kicksat/avionics/README.md

avionics
========

# This repo is no longer being updated. Please see the individual repos for the mainboard, solar panels, and antenna.

# License

[Creative Commons Attribution-ShareAlike 4.0 International](https://creativecommons.org/licenses/by-sa/4.0/)
