kicksat/avionics/kicksat1/Mainboard BOM.xlsx

Qty | Value | Device | Package | Parts | Description
3 | 4.7k | Resistor | 0805 | R1, R2, R3 | Resistor
1 | 120k | Resistor | 0805 | R4 | Resistor
1 | 68k | Resistor | 0805 | R5 | Resistor
5 | 3K3 | Resistor | 0805 | R6, R12, R17, R19, R23 | Resistor
2 | .1R prec | Resistor | 0805 | R7, R16 | Resistor
5 | 10K | Resistor | 0805 | R8, R13, R18, R21, R24 | Resistor
5 | 4.7K | Resistor | 0805 | R9, R14, R20, R22, R25 | Resistor
2 | 4.7R | Resistor | 2512 | R10, R11 | Resistor
1 | 1.33K | Resistor | 0805 | R15 | Resistor
3 | 0.1uF | Capacitor | 0805 | C1, C4, C6 | Capacitor
1 | 4.7uF | Capacitor | 0805 | C2 | Capacitor
1 | .22uF | Capacitor | 0805 | C3 | Capacitor
1 | 10nF | Capacitor | 0805 | C5 | Capacitor
1 | 2.2nF | Capacitor | 0805 | C7 | Capacitor
8 | .1uF | Capacitor | 0805 | C8, C9, C11, C13, C14, C15, C16, C17 | Capacitor
2 | 22uF | Capacitor | 1206 | C10, C12 | Capacitor
5 | MOSFET_PCHAN_20A | MOSFET_PCHAN_20A | SO8 | T1, T3, T5, T7, T9 | Power MOSFET for Burn Wires
5 | SINGLE_NCHAN_FET | SINGLE_NCHAN_FET | SOT23-3 | T2, T4, T6, T8, T10 | MOSFET for burn wire circuit
1 | RFM23BP | RFM23BP | RFM23BP | U1 | HopeRF RFM23BP Radio
1 | ARDUINO_PRO_MINI | ARDUINO_PRO_MINI | ARDUINO_PRO_MINI | U2 | Watchdog MCU
1 | HMC5883LSMD | HMC5883LSMD | 16LPCC | U3 | 3 Axis Digital Compass IC
1 | TEENSY_3.0+4 | TEENSY_3.0+4 | TEENSY_3.0+4 | U4 | Flight computer MCU
1 | ITG-3200 | ITG-3200 | QFN-24 | U5 | ITG-3200 3-axis gyro, digital output, qfn24 package
2 | CURRENT_MAX4372 | CURRENT_MAX4372 | SOT23-5 | U6, U8 | Current Sense Amplifier
1 | MURATA_REG_OKL-T3-W12 | MURATA_REG_OKL-T6-W12 | MURATA_REG_OKL-T6-W12 | U7 | Switching Regulator
5 | M023.5MM_LOCK | M023.5MM_LOCK | SCREWTERMINAL-3.5MM-2_LOCK | ST1, ST2, ST3, ST4, ST5 | Screw terminals for battery + foot switch connections
1 | BU-SMA-V | BU-SMA-V | BU-SMA-V | SMA1 | Antenna connector (MCX)
1 | CONN_5-1-53261 | CONN_5-1-53261 | PB-53261-05 | JP8 | Piksi GPS connector
7 | M03POLAR_LOCK | M03POLAR_LOCK | MOLEX-1X3_LOCK | JP1, JP2, JP3, JP4, JP5, JP6, JP7 | Solar Panel Connectors
1 | POWER_JACKPTH_LOCK | POWER_JACKPTH_LOCK | POWER_JACK_PTH_LOCK | J1 | Charging Jack
1 | DPDT | SWITCH-DPDTAYZ0202 | AYZ0202 | S1 | Switch for MCU programming mode
