kicksat/avionics/kicksat1/Mainboard.brd

## EAGLE design kicksat1/Mainboard.brd (2017-02-05)

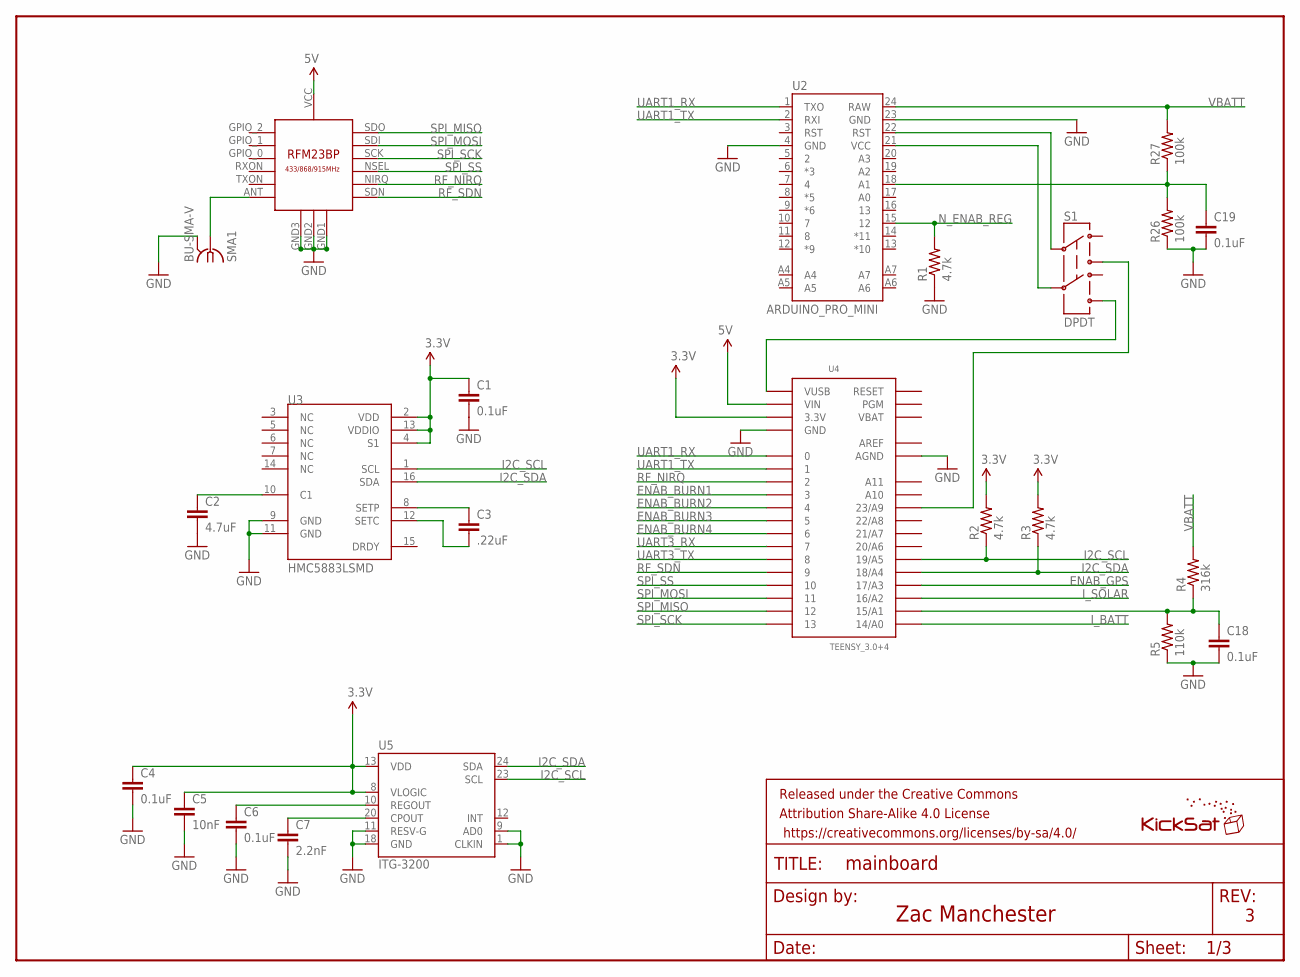
[picture p1: schematic Mainboard.sch, sheet 1, Avionics]

Parts:
C1, C4, C6, C18, C19: 0.1uF; 0805
C2: 4.7uF; 0805
C3: .22uF; 0805
C5: 10nF; 0805
C7: 2.2nF; 0805
FRAME1: FRAME-LETTER; CREATIVE_COMMONS
R1, R2, R3: 4.7k; 0805
R4: 316k; 0805
R5: 110k; 0805
R26, R27: 100k; 0805
S1: DPDT; AYZ0202
SMA1: BU-SMA-V
U1: RFM23BP
U2: ARDUINO_PRO_MINI
U3: HMC5883LSMD; 16LPCC
U4: TEENSY_3.0+4
U5: ITG-3200; QFN-24
U$3: KICKSAT_LOGO

Connections:
3.3V: C1.1, C4.1, C5.1, R2.2, R3.2, U3.2 (VDD), U3.4 (S1), U3.13 (VDDIO), U4.3.3V, U4.3.3V1 (3.3V), U5.8 (VLOGIC), U5.13 (VDD); also elsewhere on the board
5V: U1.VCC, U4.VIN; also elsewhere on the board
AREF: U4.AREF
ENAB_BURN1: U4.3; also elsewhere on the board
ENAB_BURN2: U4.4; also elsewhere on the board
ENAB_BURN3: U4.5; also elsewhere on the board
ENAB_BURN4: U4.6; also elsewhere on the board
ENAB_GPS: U4.17/A3; also elsewhere on the board
GND: C1.2, C2.2, C4.2, C5.2, C6.2, C7.2, C18.2, C19.2, R1.1, R5.1, R26.1, SMA1.2, SMA1.3 (2), SMA1.4 (2), SMA1.5 (2), U1.GND1, U1.GND2, U1.GND3, U2.4 (GND), U2.23 (GND), U3.9 (GND), U3.11 (GND), U4.AGND, U4.GND, U4.GND1 (GND), U5.1 (CLKIN), U5.9 (AD0), U5.11 (RESV-G), U5.18 (GND); also elsewhere on the board
I2C_SCL: R2.1, U3.1 (SCL), U4.19/A5, U5.23 (SCL)
I2C_SDA: R3.1, U3.16 (SDA), U4.18/A4, U5.24 (SDA)
I_BATT: U4.14/A0; also elsewhere on the board
I_SOLAR: U4.16/A2; also elsewhere on the board
unnamed: S1.3, U4.23/A9
unnamed: S1.6, U4.VUSB
unnamed: C19.1, R26.2, R27.1, U2.18 (A1)
unnamed: SMA1.1, U1.ANT
unnamed: C18.1, R4.1, R5.2, U4.15/A1
unnamed: C7.1, U5.20 (CPOUT)
unnamed: C6.1, U5.10 (REGOUT)
unnamed: C2.1, U3.10 (C1)
unnamed: C3.1, U3.8 (SETP)
unnamed: C3.2, U3.12 (SETC)
N_ENAB_REG: R1.2, U2.15 (12); also elsewhere on the board
PGM_RST: S1.2, U2.22 (RST)
PGM_VCC: S1.5, U2.21 (VCC)
RF_NIRQ: U1.NIRQ, U4.2
RF_SDN: U1.SDN, U4.9
SPI_MISO: U1.SDO, U4.12
SPI_MOSI: U1.SDI, U4.11
SPI_SCK: U1.SCK, U4.13
SPI_SS: U1.NSEL, U4.10
UART1_RX: U2.1 (TXO), U4.0
UART1_TX: U2.2 (RXI), U4.1
UART3_RX: U4.7; also elsewhere on the board
UART3_TX: U4.8; also elsewhere on the board
VBAT: U4.VBAT
VBATT: R4.2, R27.2, U2.24 (RAW); also elsewhere on the board

Notes on the sheet:
Zac Manchester

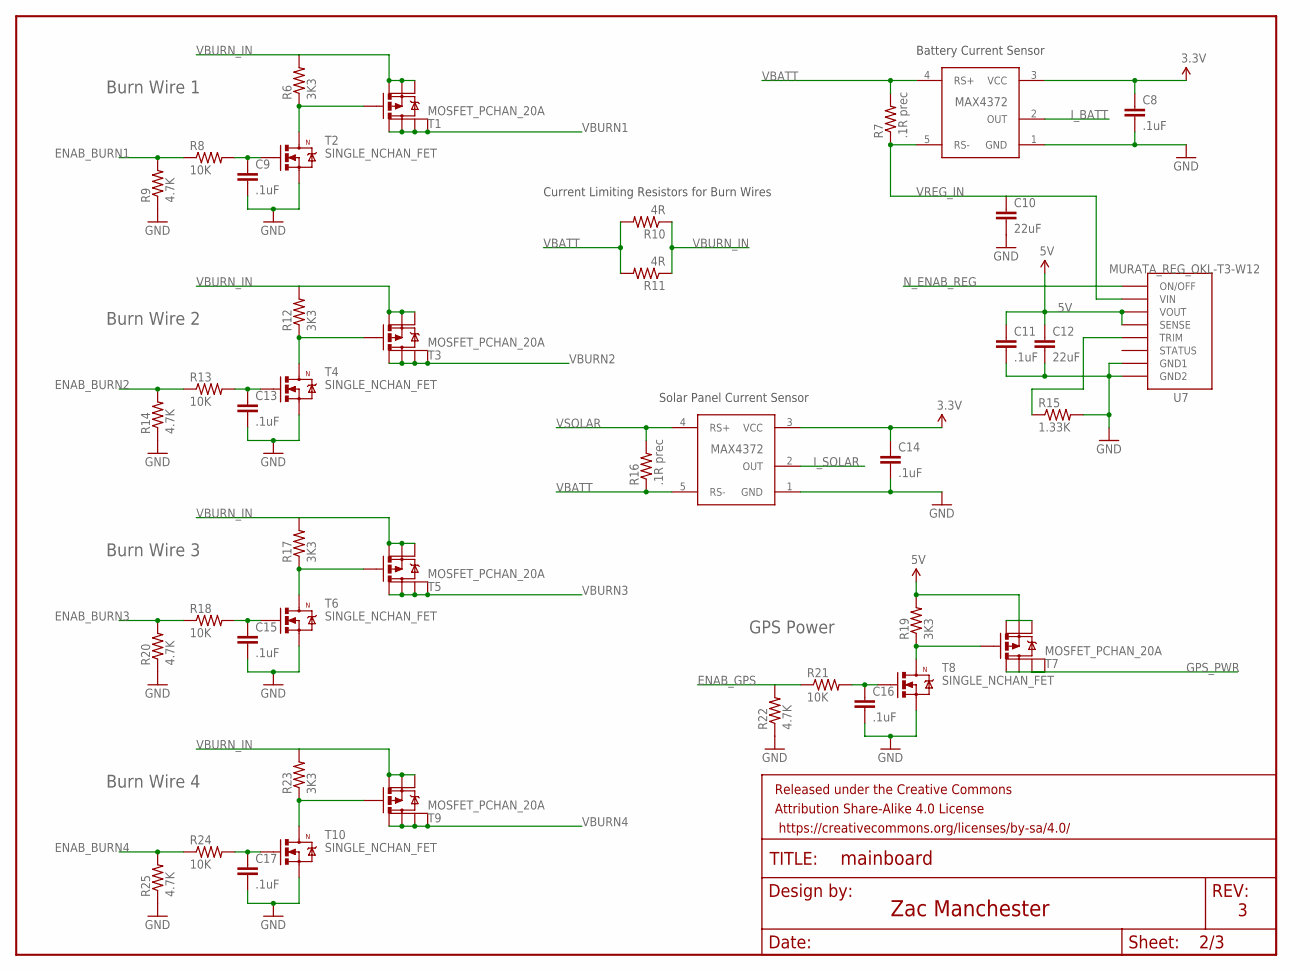
[picture p2: schematic Mainboard.sch, sheet 2, Power]

Parts:
C8, C9, C11, C13, C14, C15, C16, C17: .1uF; 0805
C10, C12: 22uF; 1206
FRAME2: FRAME-LETTER; CREATIVE_COMMONS
R6, R12, R17, R19, R23: 3K3; 0805
R7, R16: .1R prec; 0805
R8, R13, R18, R21, R24: 10K; 0805
R9, R14, R20, R22, R25: 4.7K; 0805
R10, R11: 4R; R2512
R15: 1.33K; 0805
T1, T3, T5, T7, T9: MOSFET_PCHAN_20A; SO8
T2, T4, T6, T8, T10: SINGLE_NCHAN_FET; SOT23-3
U6, U8: CURRENT_MAX4372; SOT23-5
U7: MURATA_REG_OKL-T3-W12; MURATA_REG_OKL-T6-W12

Connections:
3.3V: C8.1, C14.1, U6.3 (VCC), U8.3 (VCC); also elsewhere on the board
5V: C11.1, C12.1, R19.2, T7.1 (S), T7.2 (S), T7.3 (S), U7.4 (VOUT), U7.5 (SENSE); also elsewhere on the board
ENAB_BURN1: R8.1, R9.2; also elsewhere on the board
ENAB_BURN2: R13.1, R14.2; also elsewhere on the board
ENAB_BURN3: R18.1, R20.2; also elsewhere on the board
ENAB_BURN4: R24.1, R25.2; also elsewhere on the board
ENAB_GPS: R21.1, R22.2; also elsewhere on the board
GND: C8.2, C9.2, C10.2, C11.2, C12.2, C13.2, C14.2, C15.2, C16.2, C17.2, R9.1, R14.1, R15.2, R20.1, R22.1, R25.1, T2.2 (S), T4.2 (S), T6.2 (S), T8.2 (S), T10.2 (S), U6.1 (GND), U7.3 (GND1), U7.7 (GND2), U8.1 (GND); also elsewhere on the board
GPS_PWR: T7.5 (D), T7.6 (D), T7.7 (D), T7.8 (D); also elsewhere on the board
I_BATT: U6.2 (OUT); also elsewhere on the board
I_SOLAR: U8.2 (OUT); also elsewhere on the board
unnamed: C13.1, R13.2, T4.1 (G)
unnamed: R12.1, T3.4 (G), T4.3 (D)
unnamed: C15.1, R18.2, T6.1 (G)
unnamed: R17.1, T5.4 (G), T6.3 (D)
unnamed: R15.1, U7.6 (TRIM)
unnamed: C17.1, R24.2, T10.1 (G)
unnamed: R23.1, T9.4 (G), T10.3 (D)
unnamed: C16.1, R21.2, T8.1 (G)
unnamed: R19.1, T7.4 (G), T8.3 (D)
unnamed: C9.1, R8.2, T2.1 (G)
unnamed: R6.1, T1.4 (G), T2.3 (D)
N_ENAB_REG: U7.1 (ON/OFF); also elsewhere on the board
VBATT: R7.2, R10.2, R11.2, R16.1, U6.4 (RS+), U8.5 (RS-); also elsewhere on the board
VBURN1: T1.5 (D), T1.6 (D), T1.7 (D), T1.8 (D); also elsewhere on the board
VBURN2: T3.5 (D), T3.6 (D), T3.7 (D), T3.8 (D); also elsewhere on the board
VBURN3: T5.5 (D), T5.6 (D), T5.7 (D), T5.8 (D); also elsewhere on the board
VBURN4: T9.5 (D), T9.6 (D), T9.7 (D), T9.8 (D); also elsewhere on the board
VBURN_IN: R6.2, R10.1, R11.1, R12.2, R17.2, R23.2, T1.1 (S), T1.2 (S), T1.3 (S), T3.1 (S), T3.2 (S), T3.3 (S), T5.1 (S), T5.2 (S), T5.3 (S), T9.1 (S), T9.2 (S), T9.3 (S)
VREG_IN: C10.1, R7.1, U6.5 (RS-), U7.2 (VIN)
VSOLAR: R16.2, U8.4 (RS+); also elsewhere on the board

Notes on the sheet:
Burn Wire 1
Burn Wire 2
Burn Wire 3
Solar Panel Current Sensor
Battery Current Sensor
Burn Wire 4
Current Limiting Resistors for Burn Wires
Zac Manchester
GPS Power

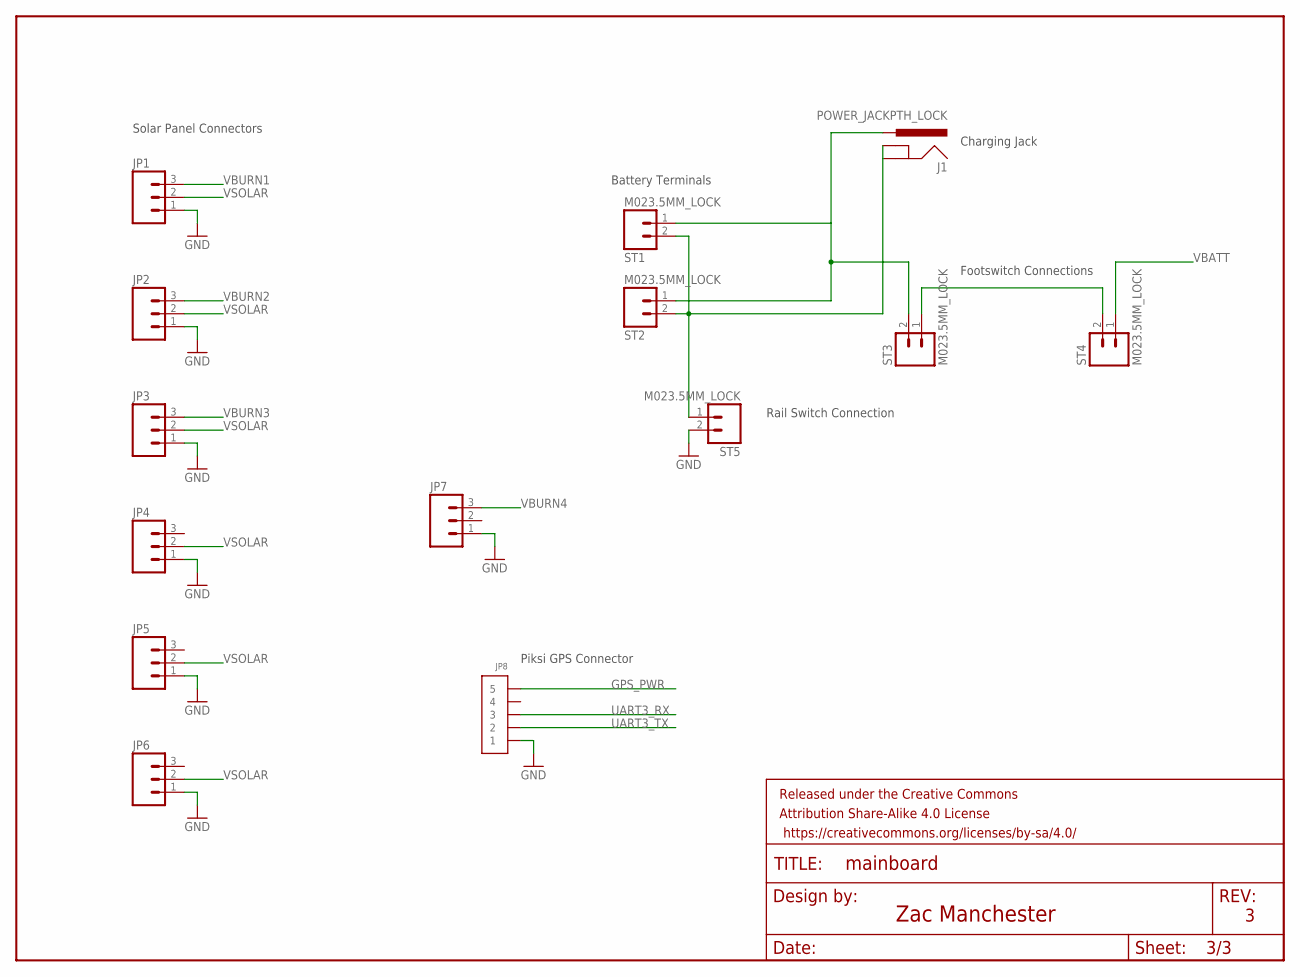
[picture p3: schematic Mainboard.sch, sheet 3, Connectors]

Parts:
FRAME3: FRAME-LETTER; CREATIVE_COMMONS
J1: POWER_JACKPTH_LOCK; POWER_JACK_PTH_LOCK
JP1, JP2, JP3, JP4, JP5, JP6, JP7: M03POLAR_LOCK; MOLEX-1X3_LOCK
JP8: CONN_5-1-53261; PB-53261-05
ST1, ST2, ST3, ST4, ST5: M023.5MM_LOCK; SCREWTERMINAL-3.5MM-2_LOCK

Connections:
BATT_INPUT: J1.PWR, ST1.1, ST2.1, ST3.2
GND: JP1.1, JP2.1, JP3.1, JP4.1, JP5.1, JP6.1, JP7.1, JP8.1, ST5.2; also elsewhere on the board
GPS_PWR: JP8.5; also elsewhere on the board
unnamed: J1.GND, J1.GNDBREAK, ST1.2, ST2.2, ST5.1
unnamed: ST3.1, ST4.2
UART3_RX: JP8.3; also elsewhere on the board
UART3_TX: JP8.2; also elsewhere on the board
VBATT: ST4.1; also elsewhere on the board
VBURN1: JP1.3; also elsewhere on the board
VBURN2: JP2.3; also elsewhere on the board
VBURN3: JP3.3; also elsewhere on the board
VBURN4: JP7.3; also elsewhere on the board
VSOLAR: JP1.2, JP2.2, JP3.2, JP4.2, JP5.2, JP6.2; also elsewhere on the board

Notes on the sheet:
Footswitch Connections
Solar Panel Connectors
Battery Terminals
Rail Switch Connection
Charging Jack
Piksi GPS Connector
Zac Manchester

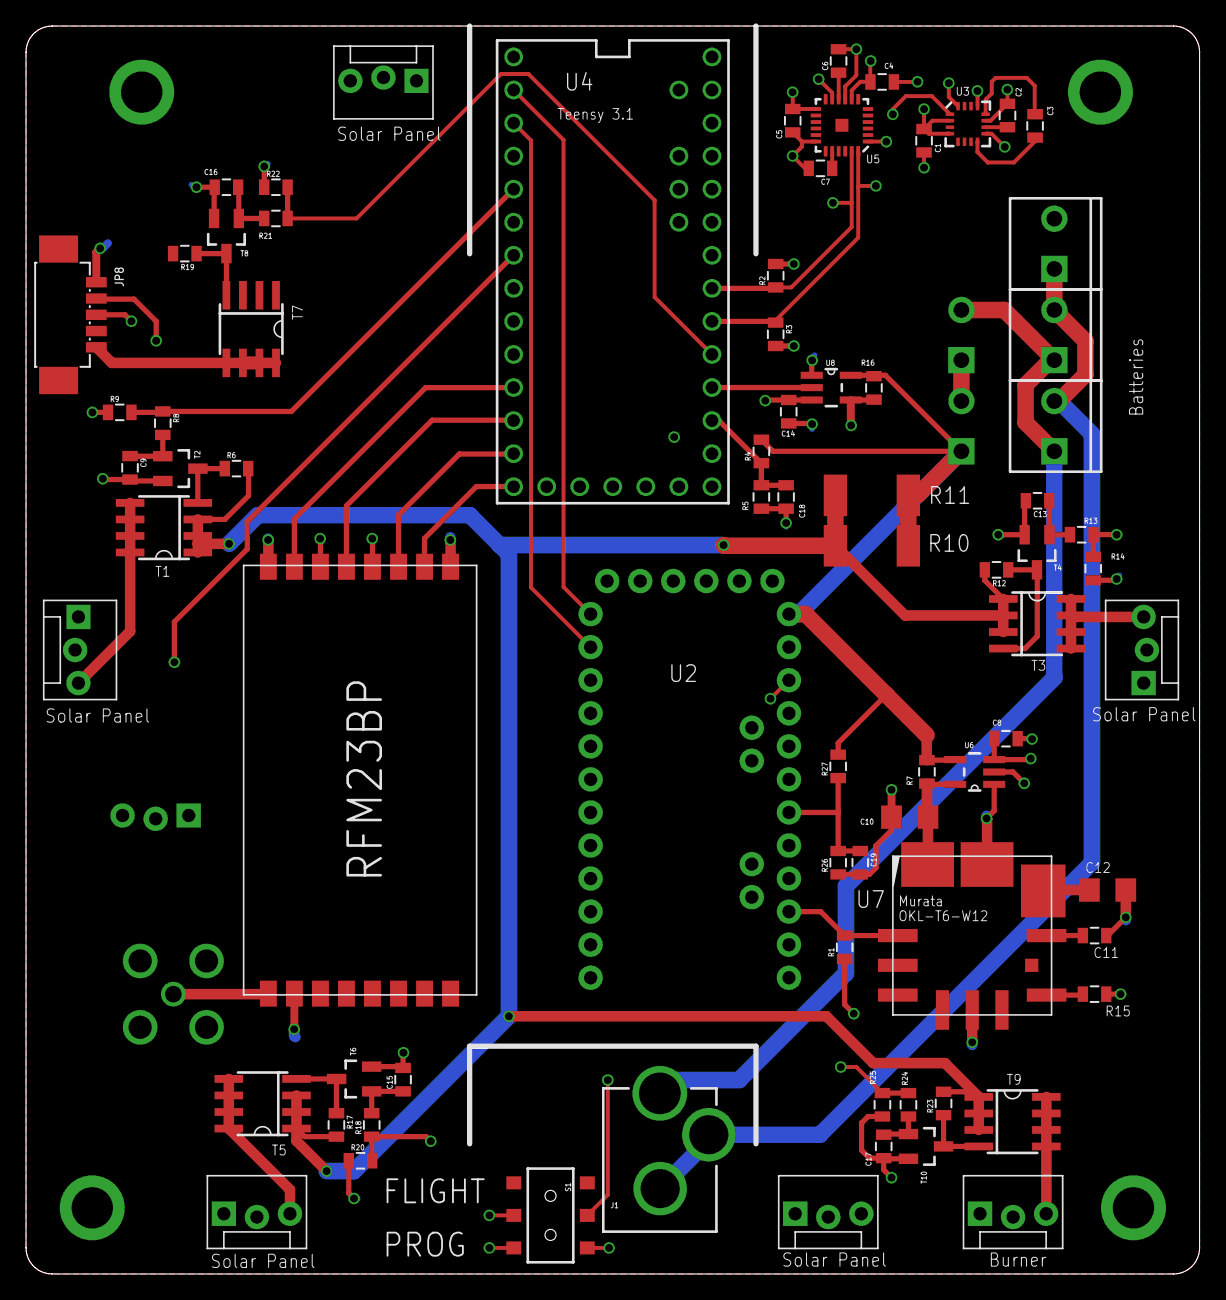
[picture p4: board Mainboard.brd from above]

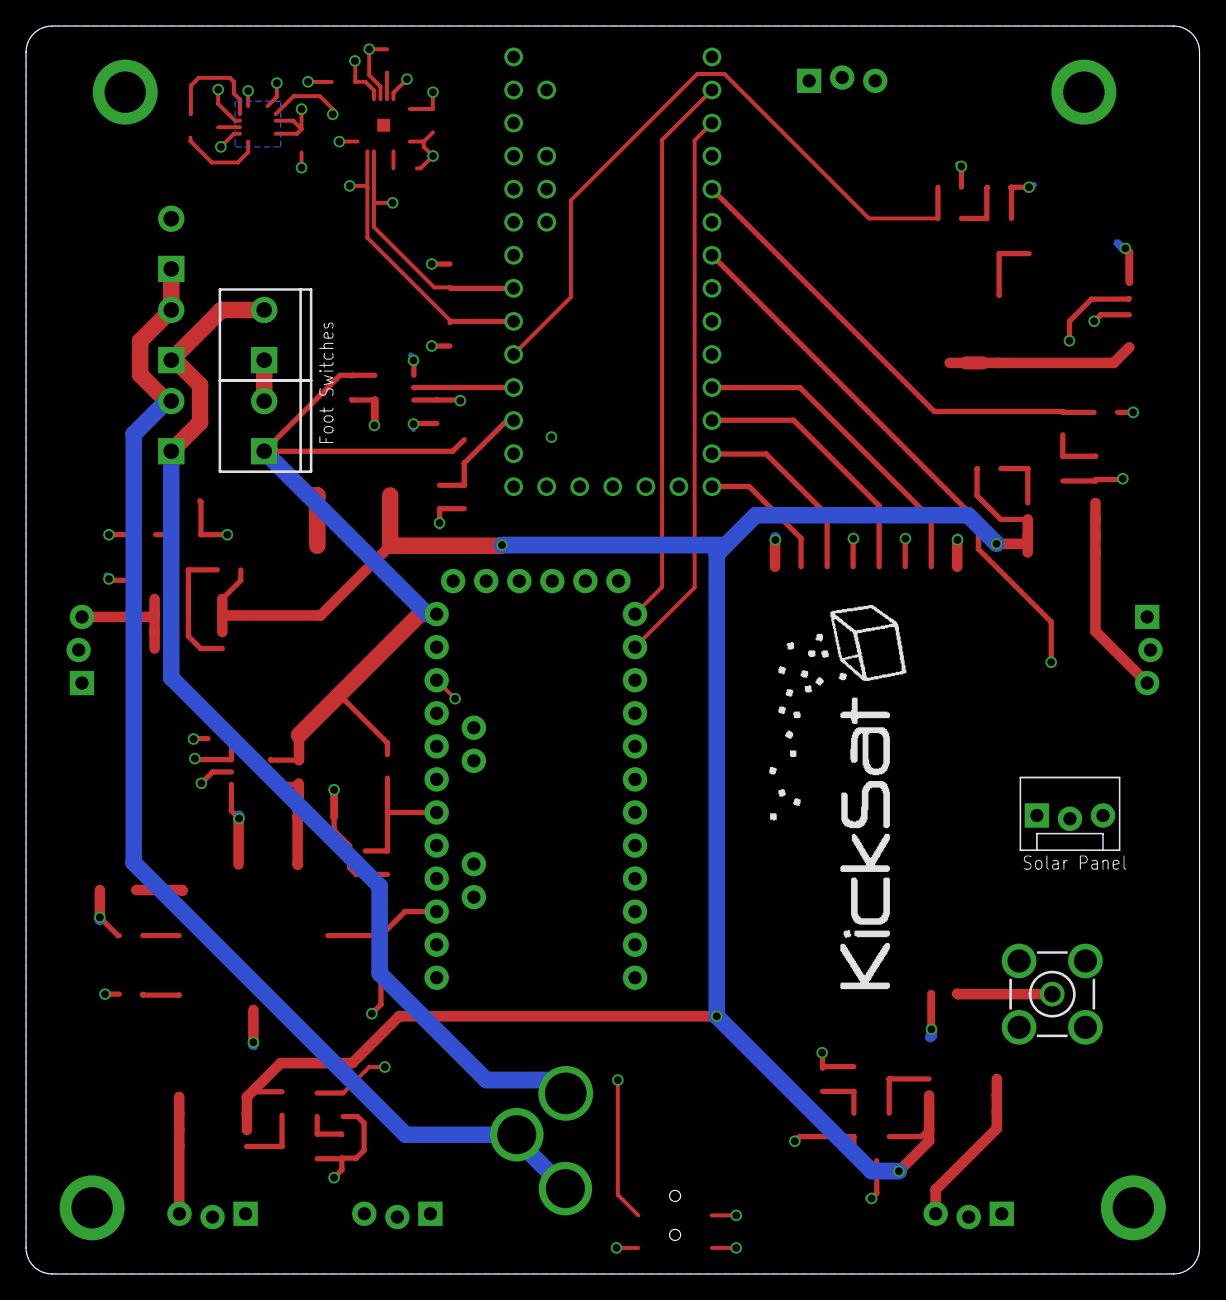
[picture p5: board Mainboard.brd from below]

Board: 4 copper layers, 90.2 x 95.9 mm, 84 parts (5 on the bottom side), 58 nets.
