kicksat/avionics/kicksat1/TopSolarPanel.brd

## EAGLE design kicksat1/TopSolarPanel.brd (2016-02-21)

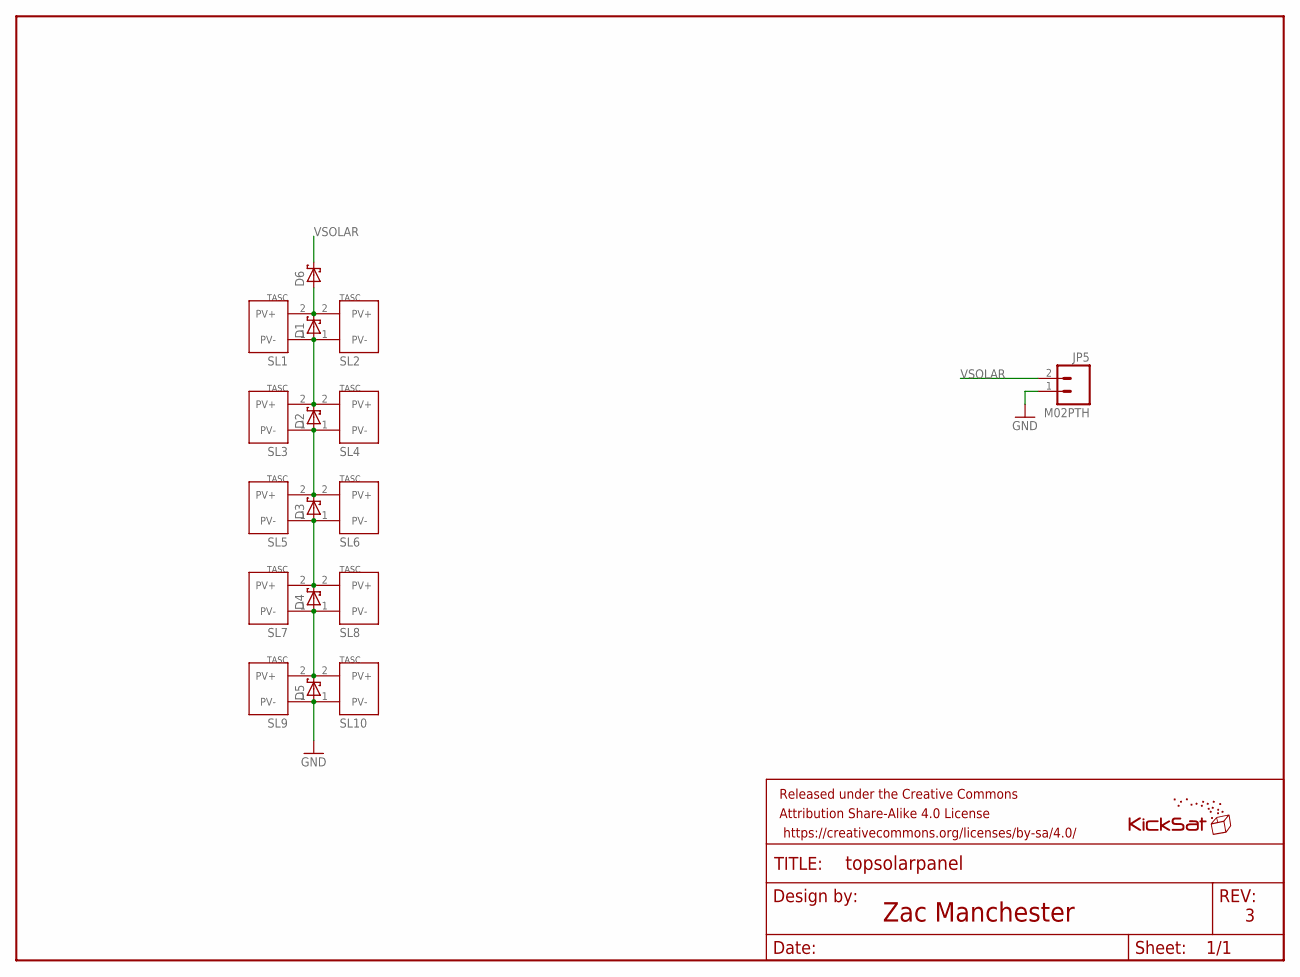
[picture p6: schematic TopSolarPanel.sch]

Parts:
D1, D2, D3, D4, D5, D6: SB_DIODE
FRAME1: FRAME-LETTER; CREATIVE_COMMONS
JP5: M02PTH; 1X02
SL1, SL2, SL3, SL4, SL5, SL6, SL7, SL8, SL9, SL10: SOLAR_CELL
U$1: KICKSAT_LOGO

Connections:
GND: D5.POS, JP5.1, SL9.1 (PV-), SL10.1 (PV-)
unnamed: D1.NEG, D6.POS, SL1.2 (PV+), SL2.2 (PV+)
unnamed: D2.POS, D3.NEG, SL3.1 (PV-), SL4.1 (PV-), SL5.2 (PV+), SL6.2 (PV+)
unnamed: D3.POS, D4.NEG, SL5.1 (PV-), SL6.1 (PV-), SL7.2 (PV+), SL8.2 (PV+)
unnamed: D1.POS, D2.NEG, SL1.1 (PV-), SL2.1 (PV-), SL3.2 (PV+), SL4.2 (PV+)
unnamed: D4.POS, D5.NEG, SL7.1 (PV-), SL8.1 (PV-), SL9.2 (PV+), SL10.2 (PV+)
VSOLAR: D6.NEG, JP5.2

Notes on the sheet:
Zac Manchester

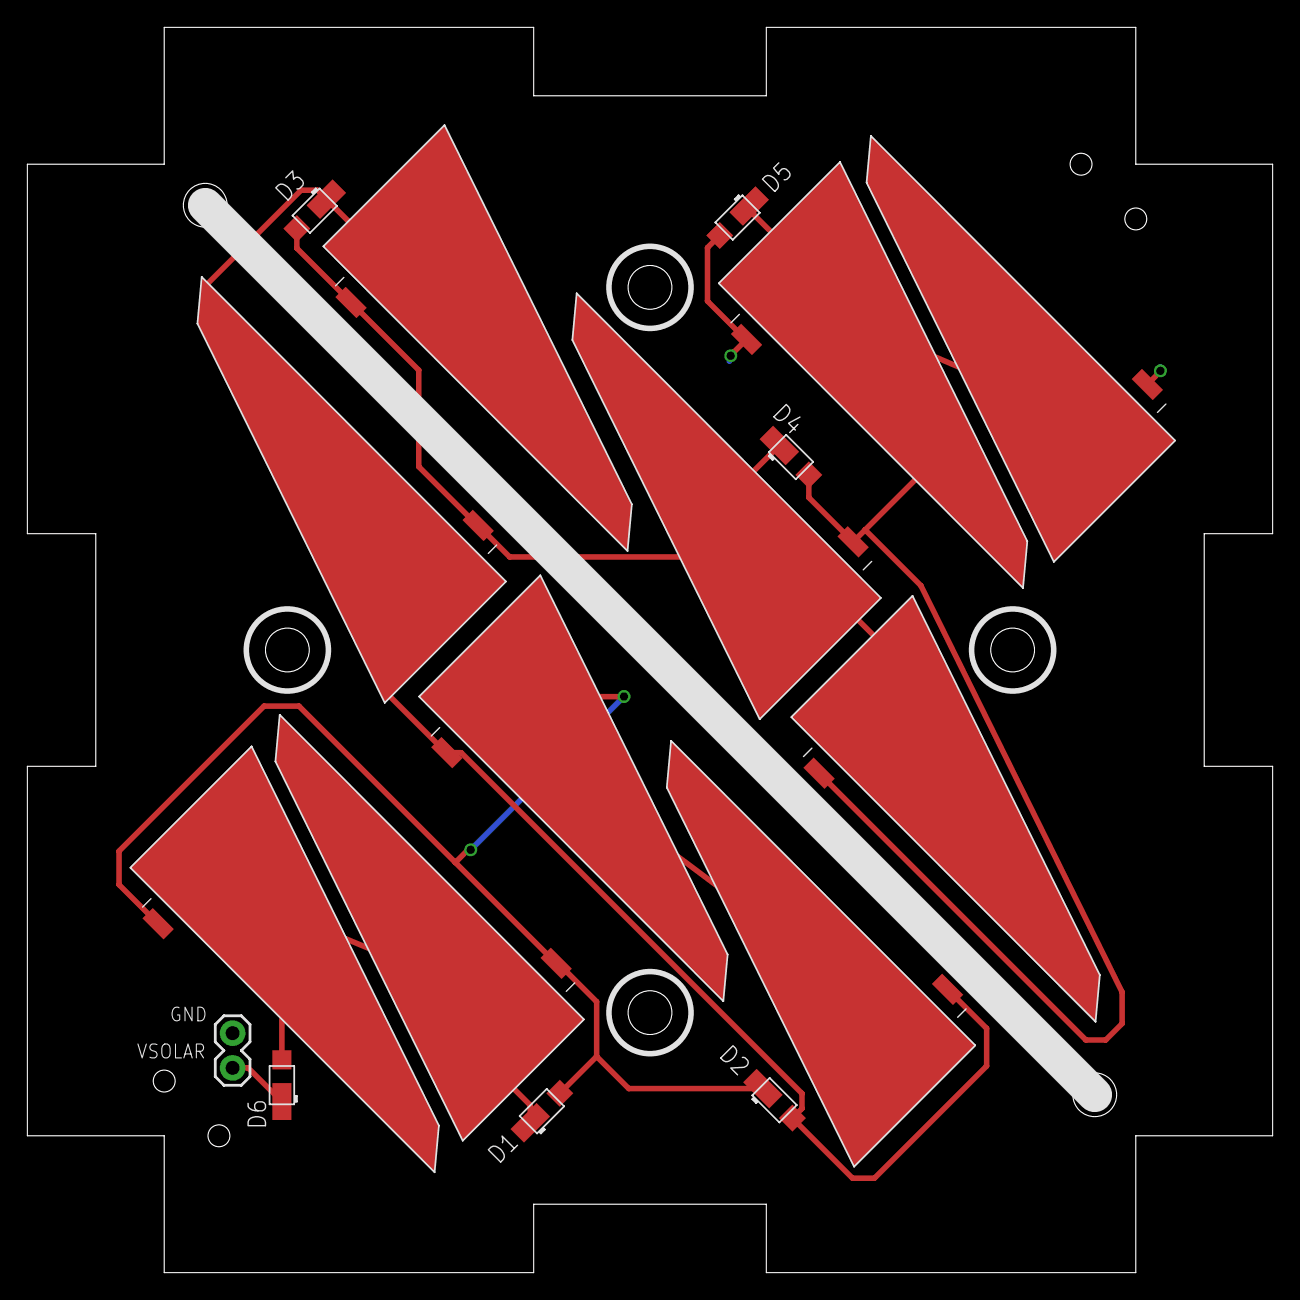
[picture p7: board TopSolarPanel.brd from above]

Board: 2 copper layers, 91.0 x 91.0 mm, 19 parts (1 on the bottom side), 7 nets.
