kicksat/avionics/kicksat1/Antenna.brd

## EAGLE design kicksat1/Antenna.brd (2015-09-23)

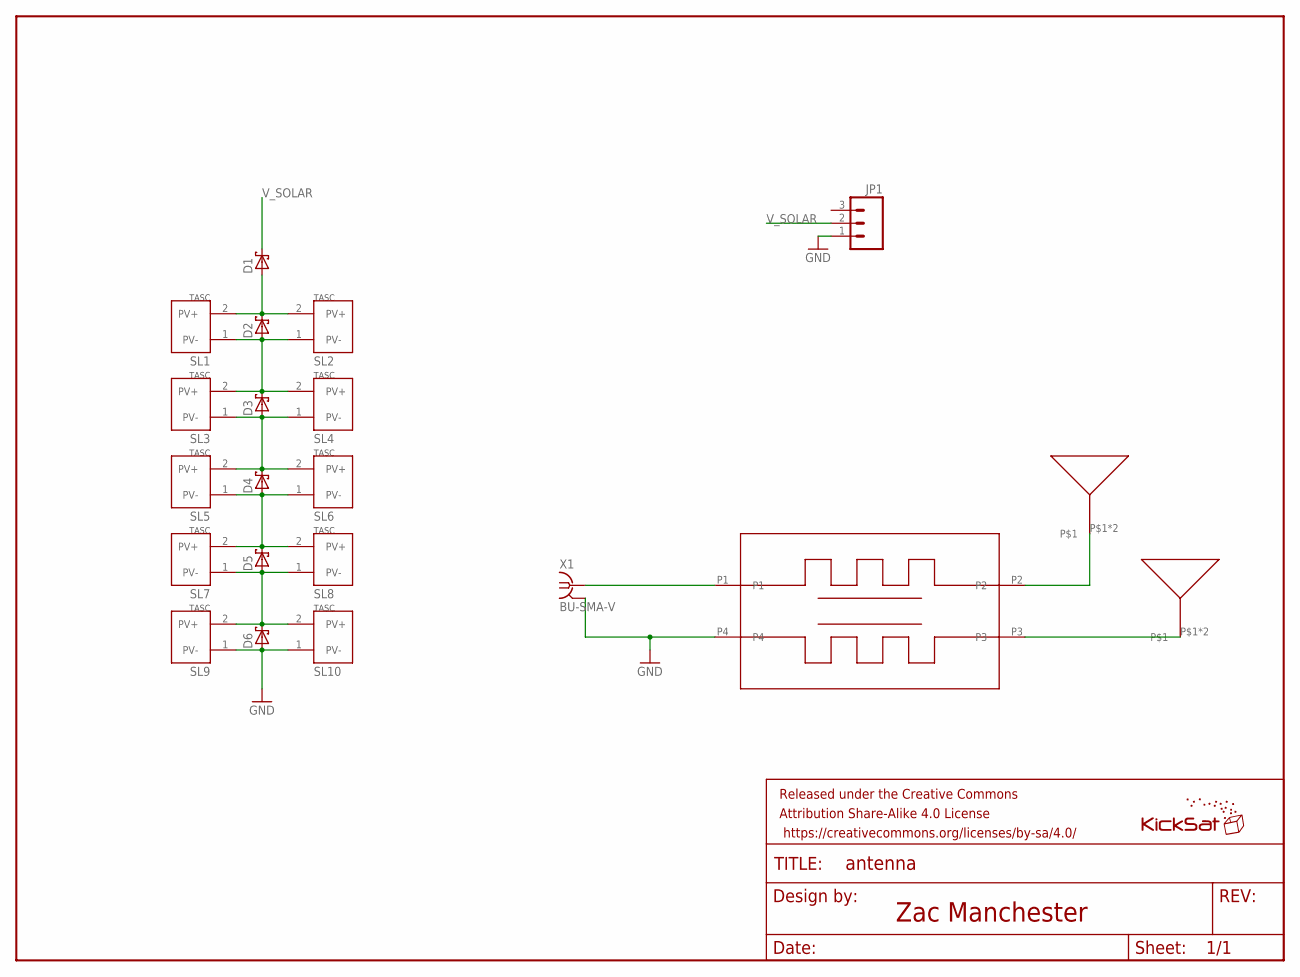
[picture p8: schematic Antenna.sch]

Parts:
B1: BALUN
D1, D2, D3, D4, D5, D6: SB_DIODE
FRAME1: FRAME-LETTER; CREATIVE_COMMONS
JP1: M03POLAR_LOCK; MOLEX-1X3_LOCK
SL1, SL2, SL3, SL4, SL5, SL6, SL7, SL8, SL9, SL10: SOLAR_CELL
U$1, U$2: TAPEANTENNA
U$3: KICKSAT_LOGO
X1: BU-SMA-V

Connections:
GND: B1.P4, D6.POS, JP1.1, SL9.1 (PV-), SL10.1 (PV-), X1.2, X1.3 (2), X1.4 (2), X1.5 (2)
unnamed: B1.P1, X1.1
unnamed: D1.POS, D2.NEG, SL1.2 (PV+), SL2.2 (PV+)
unnamed: D3.POS, D4.NEG, SL3.1 (PV-), SL4.1 (PV-), SL5.2 (PV+), SL6.2 (PV+)
unnamed: D4.POS, D5.NEG, SL5.1 (PV-), SL6.1 (PV-), SL7.2 (PV+), SL8.2 (PV+)
unnamed: D2.POS, D3.NEG, SL1.1 (PV-), SL2.1 (PV-), SL3.2 (PV+), SL4.2 (PV+)
unnamed: D5.POS, D6.NEG, SL7.1 (PV-), SL8.1 (PV-), SL9.2 (PV+), SL10.2 (PV+)
RFN: B1.P2, U$1.P$1, U$1.P$2
RFP: B1.P3, U$2.P$1, U$2.P$2
V_SOLAR: D1.NEG, JP1.2

Notes on the sheet:
Zac Manchester

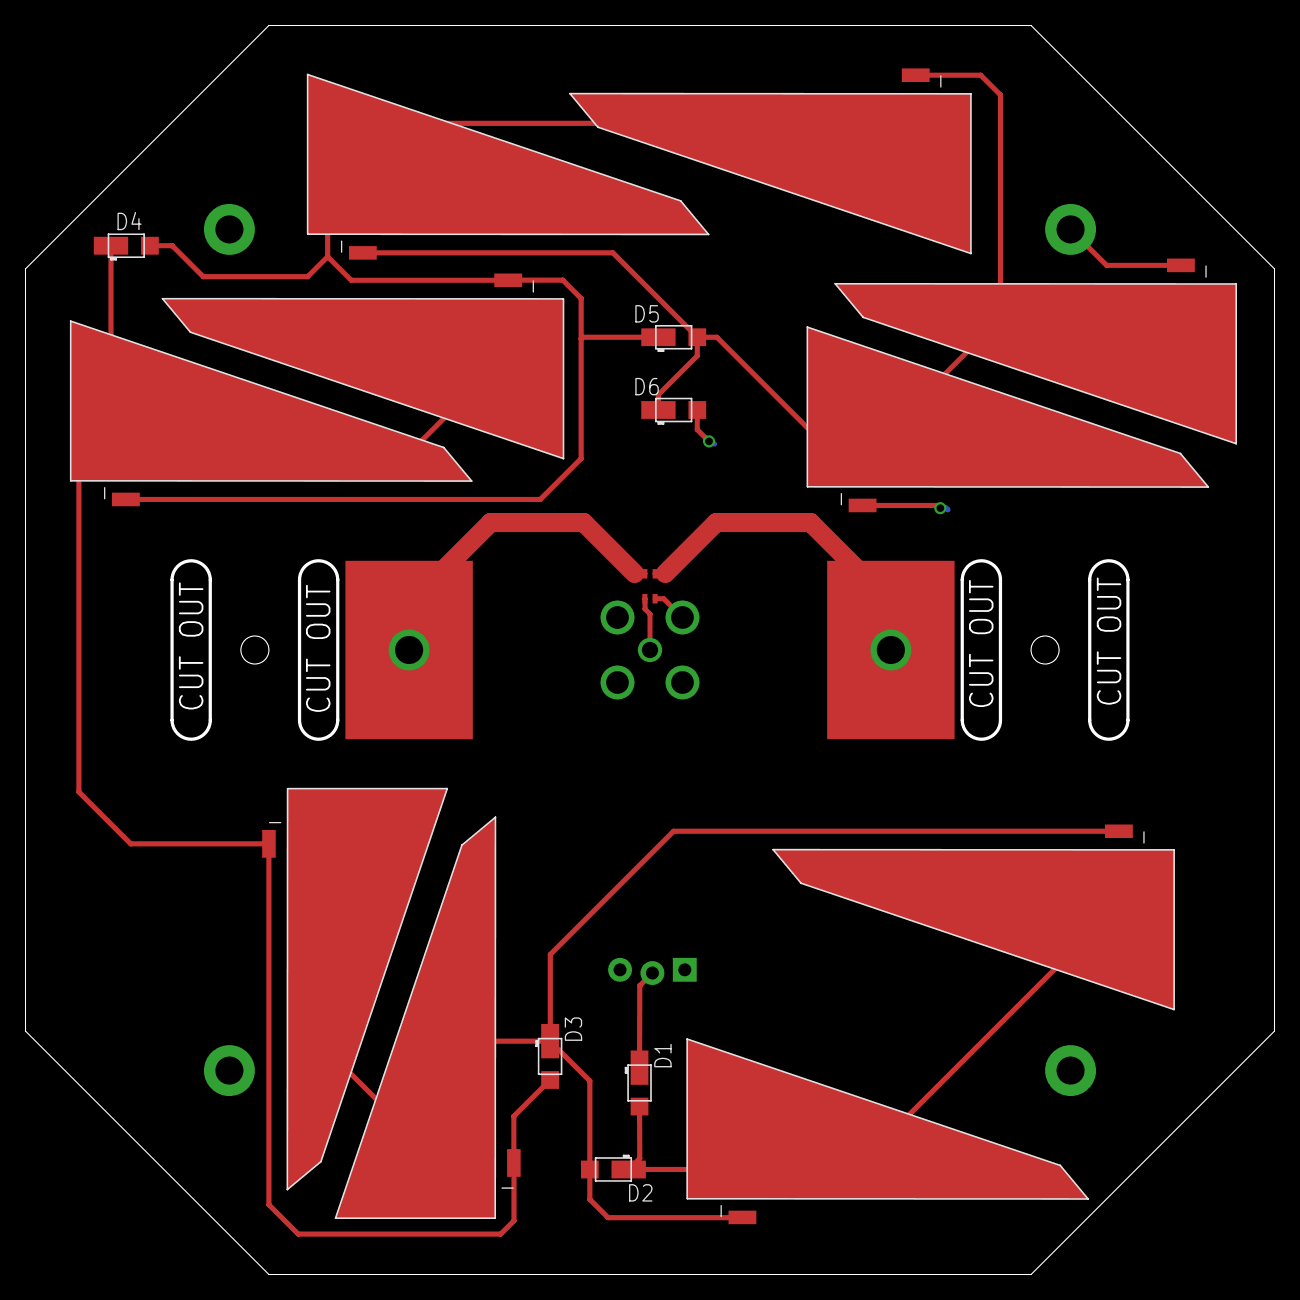
[picture p9: board Antenna.brd from above]

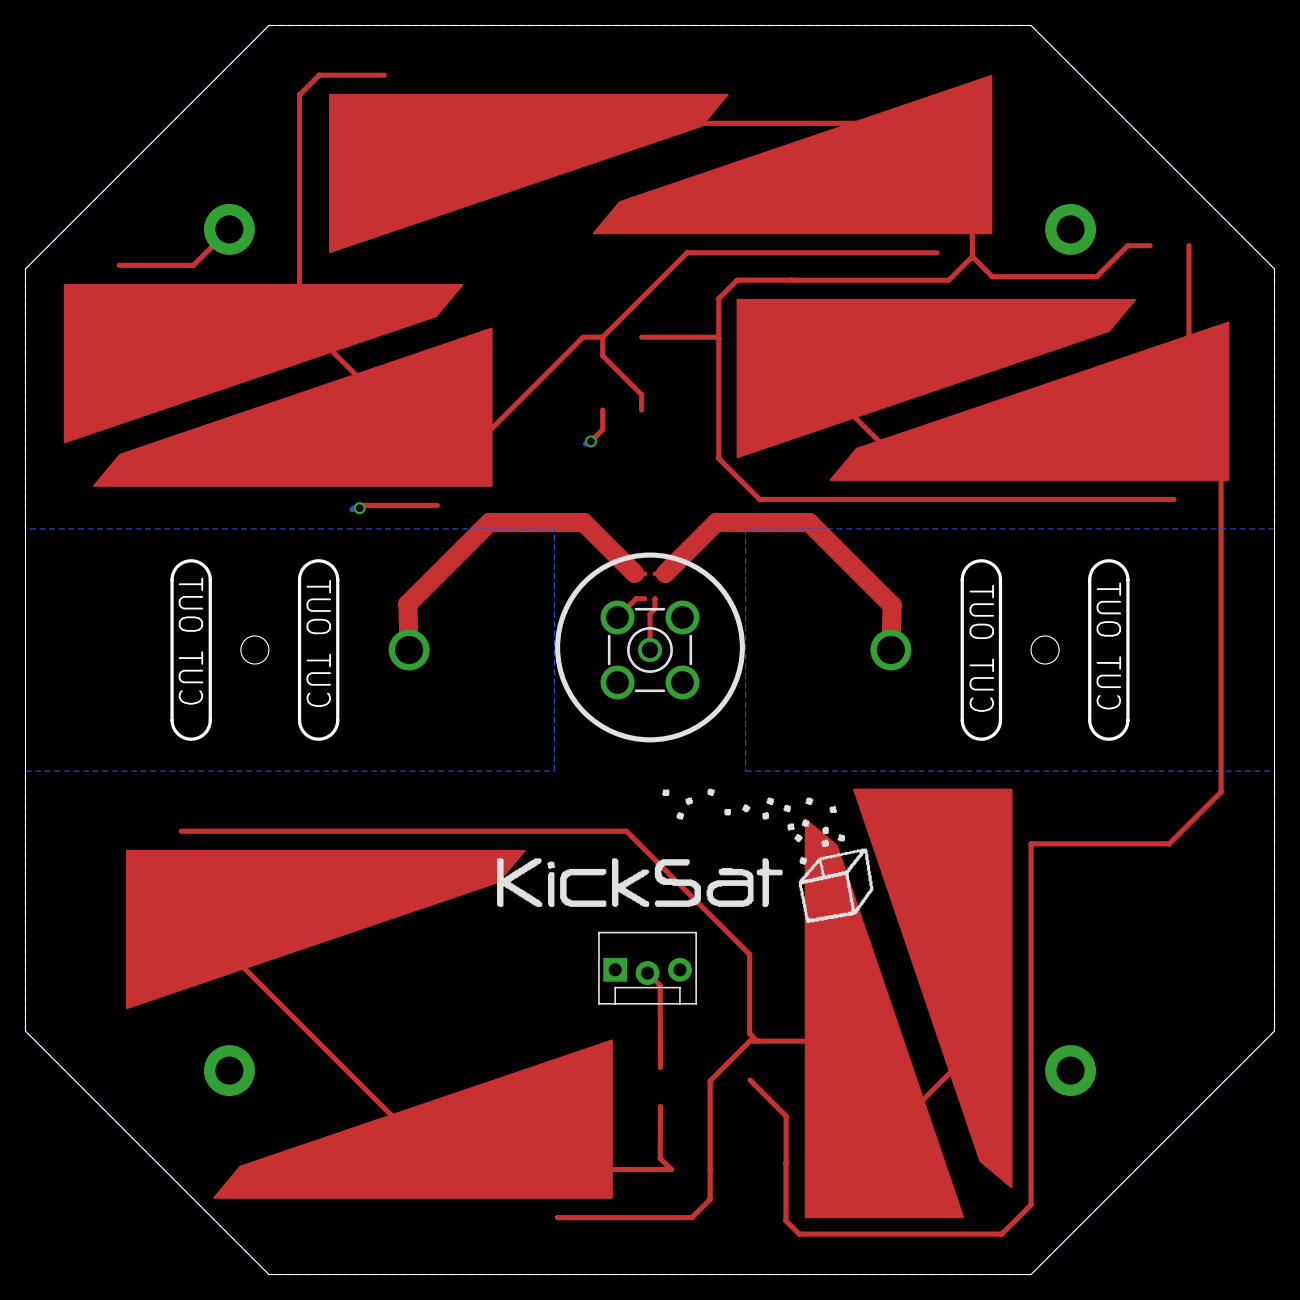
[picture p10: board Antenna.brd from below]

Board: 2 copper layers, 98.0 x 98.0 mm, 23 parts (3 on the bottom side), 10 nets.
