kicksat/avionics/kicksat1/SideYSolarPanel.brd

## EAGLE design kicksat1/SideYSolarPanel.brd (2015-11-01)

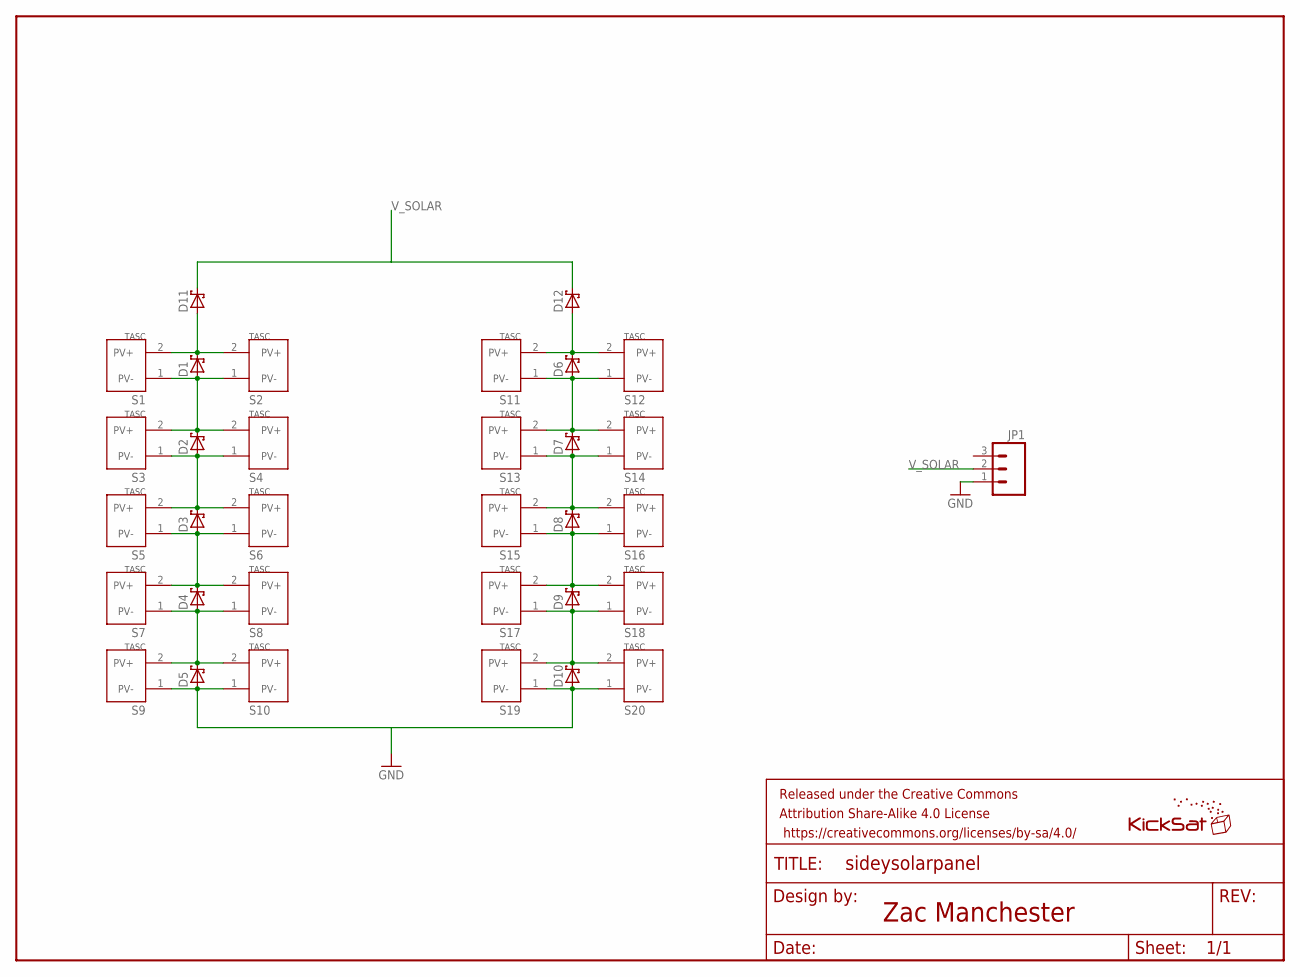
[picture p11: schematic SideYSolarPanel.sch]

Parts:
D1, D2, D3, D4, D5, D6, D7, D8, D9, D10, D11, D12: SB_DIODE
FRAME1: FRAME-LETTER; CREATIVE_COMMONS
JP1: M03POLAR_LOCK; MOLEX-1X3_LOCK
S1, S2, S3, S4, S5, S6, S7, S8, S9, S10, S11, S12, S13, S14, S15, S16, S17, S18, S19, S20: SOLAR_CELL
U$1: KICKSAT_LOGO

Connections:
GND: D5.POS, D10.POS, JP1.1, S9.1 (PV-), S10.1 (PV-), S19.1 (PV-), S20.1 (PV-)
unnamed: D6.POS, D7.NEG, S11.1 (PV-), S12.1 (PV-), S13.2 (PV+), S14.2 (PV+)
unnamed: D6.NEG, D12.POS, S11.2 (PV+), S12.2 (PV+)
unnamed: D7.POS, D8.NEG, S13.1 (PV-), S14.1 (PV-), S15.2 (PV+), S16.2 (PV+)
unnamed: D1.NEG, D11.POS, S1.2 (PV+), S2.2 (PV+)
unnamed: D8.POS, D9.NEG, S15.1 (PV-), S16.1 (PV-), S17.2 (PV+), S18.2 (PV+)
unnamed: D2.POS, D3.NEG, S3.1 (PV-), S4.1 (PV-), S5.2 (PV+), S6.2 (PV+)
unnamed: D3.POS, D4.NEG, S5.1 (PV-), S6.1 (PV-), S7.2 (PV+), S8.2 (PV+)
unnamed: D9.POS, D10.NEG, S17.1 (PV-), S18.1 (PV-), S19.2 (PV+), S20.2 (PV+)
unnamed: D1.POS, D2.NEG, S1.1 (PV-), S2.1 (PV-), S3.2 (PV+), S4.2 (PV+)
unnamed: D4.POS, D5.NEG, S7.1 (PV-), S8.1 (PV-), S9.2 (PV+), S10.2 (PV+)
V_SOLAR: D11.NEG, D12.NEG, JP1.2

Notes on the sheet:
Zac Manchester
