kicksat/avionics/kicksat1/SideYSolarPanel.brd

## EAGLE design kicksat1/SideYSolarPanel.brd (continued)

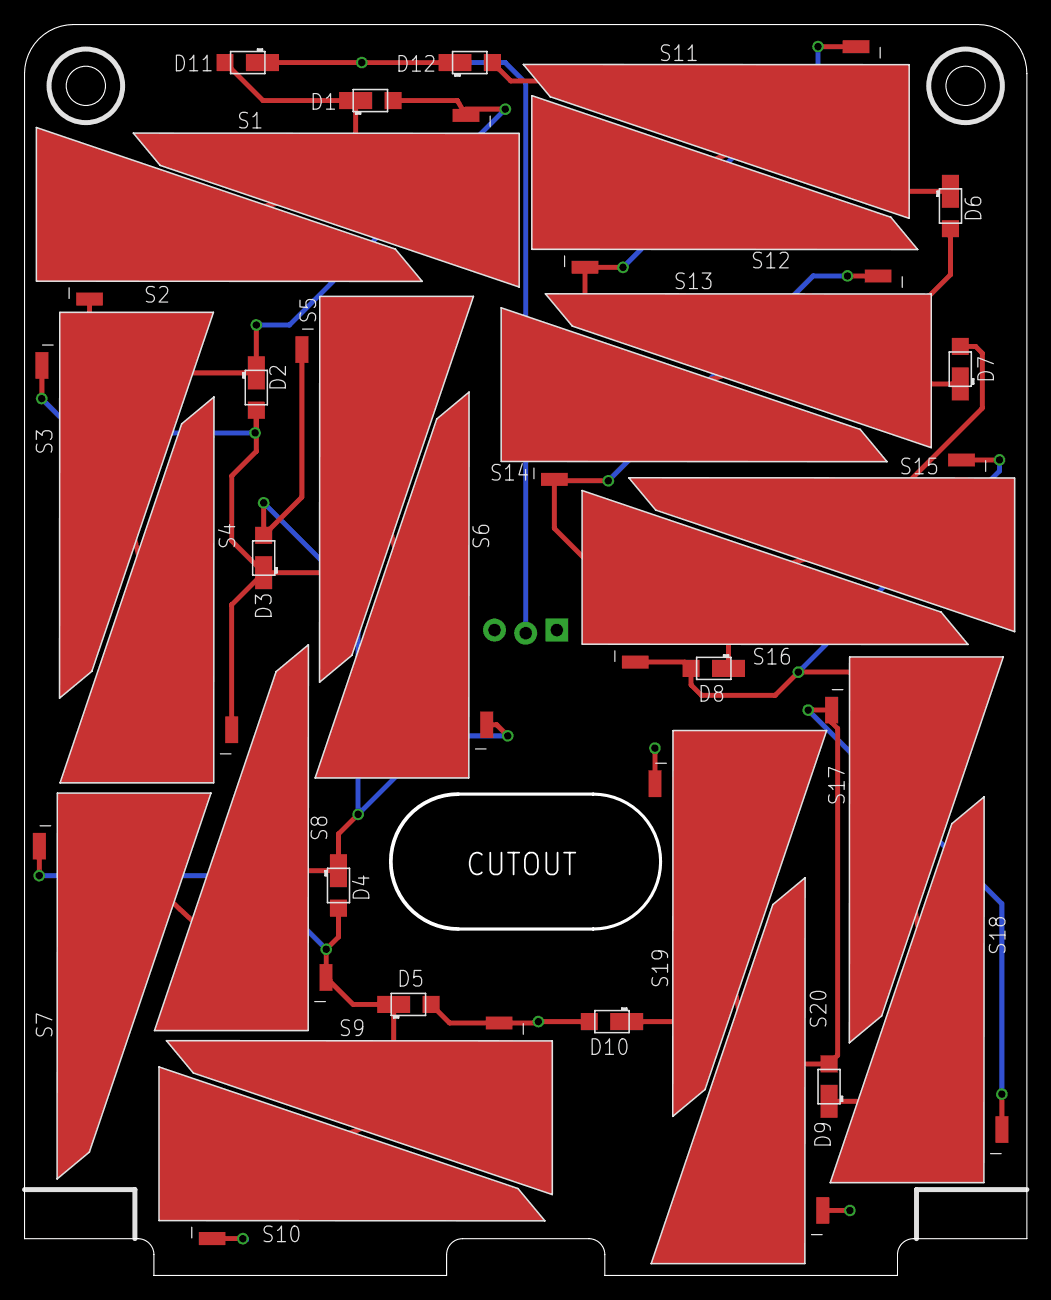
[picture p12: board SideYSolarPanel.brd from above]

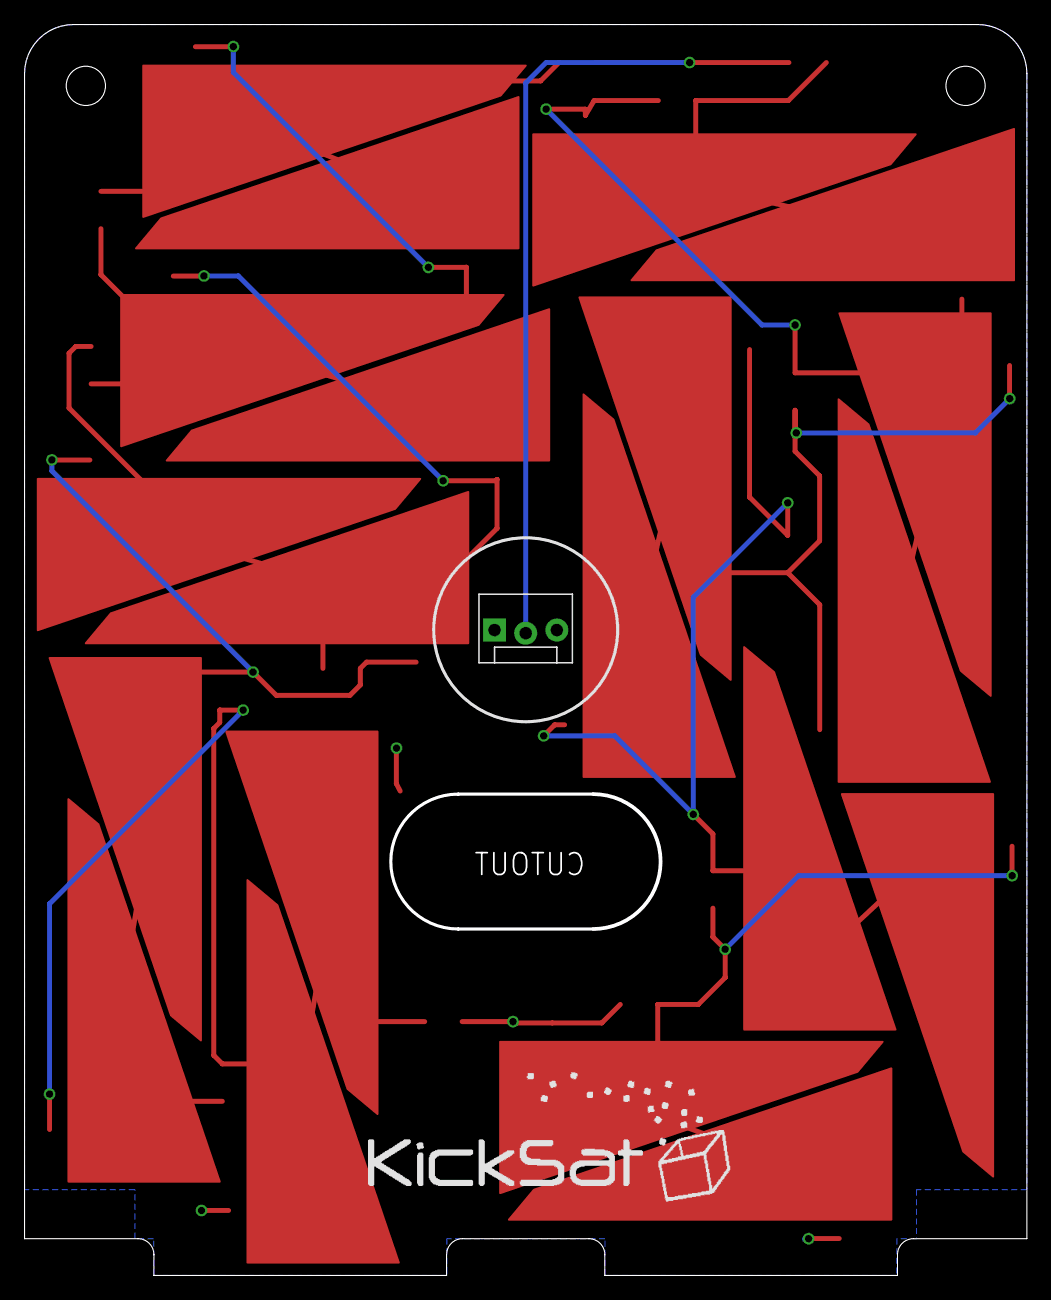
[picture p13: board SideYSolarPanel.brd from below]

Board: 2 copper layers, 81.7 x 102.0 mm, 35 parts (2 on the bottom side), 12 nets.
