kicksat/avionics/kicksat1/PogoBoard.brd

## EAGLE design kicksat1/PogoBoard.brd (2015-09-25)

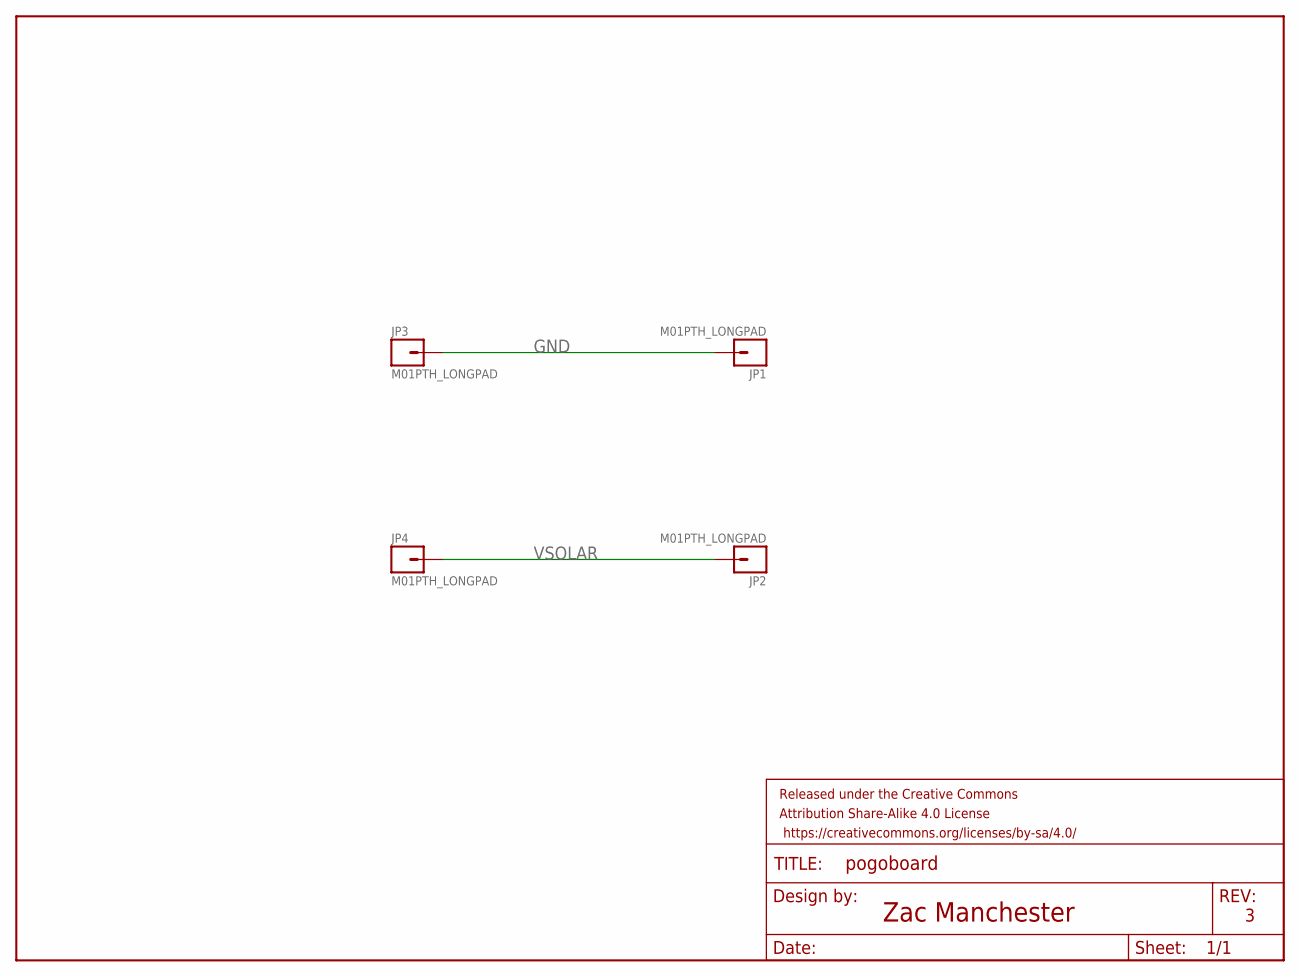
[picture p14: schematic PogoBoard.sch]

Parts:
FRAME1: FRAME-LETTER; CREATIVE_COMMONS
JP1, JP2, JP3, JP4: M01PTH_LONGPAD; 1X01_LONGPAD

Connections:
GND: JP1.1, JP3.1
VSOLAR: JP2.1, JP4.1

Notes on the sheet:
Zac Manchester

Board: 2 copper layers, 5 parts (0 on the bottom side), 2 nets, no tracks yet.
