kicksat/avionics/Mainbaord.brd

## EAGLE design Mainbaord.brd (2018-04-04)

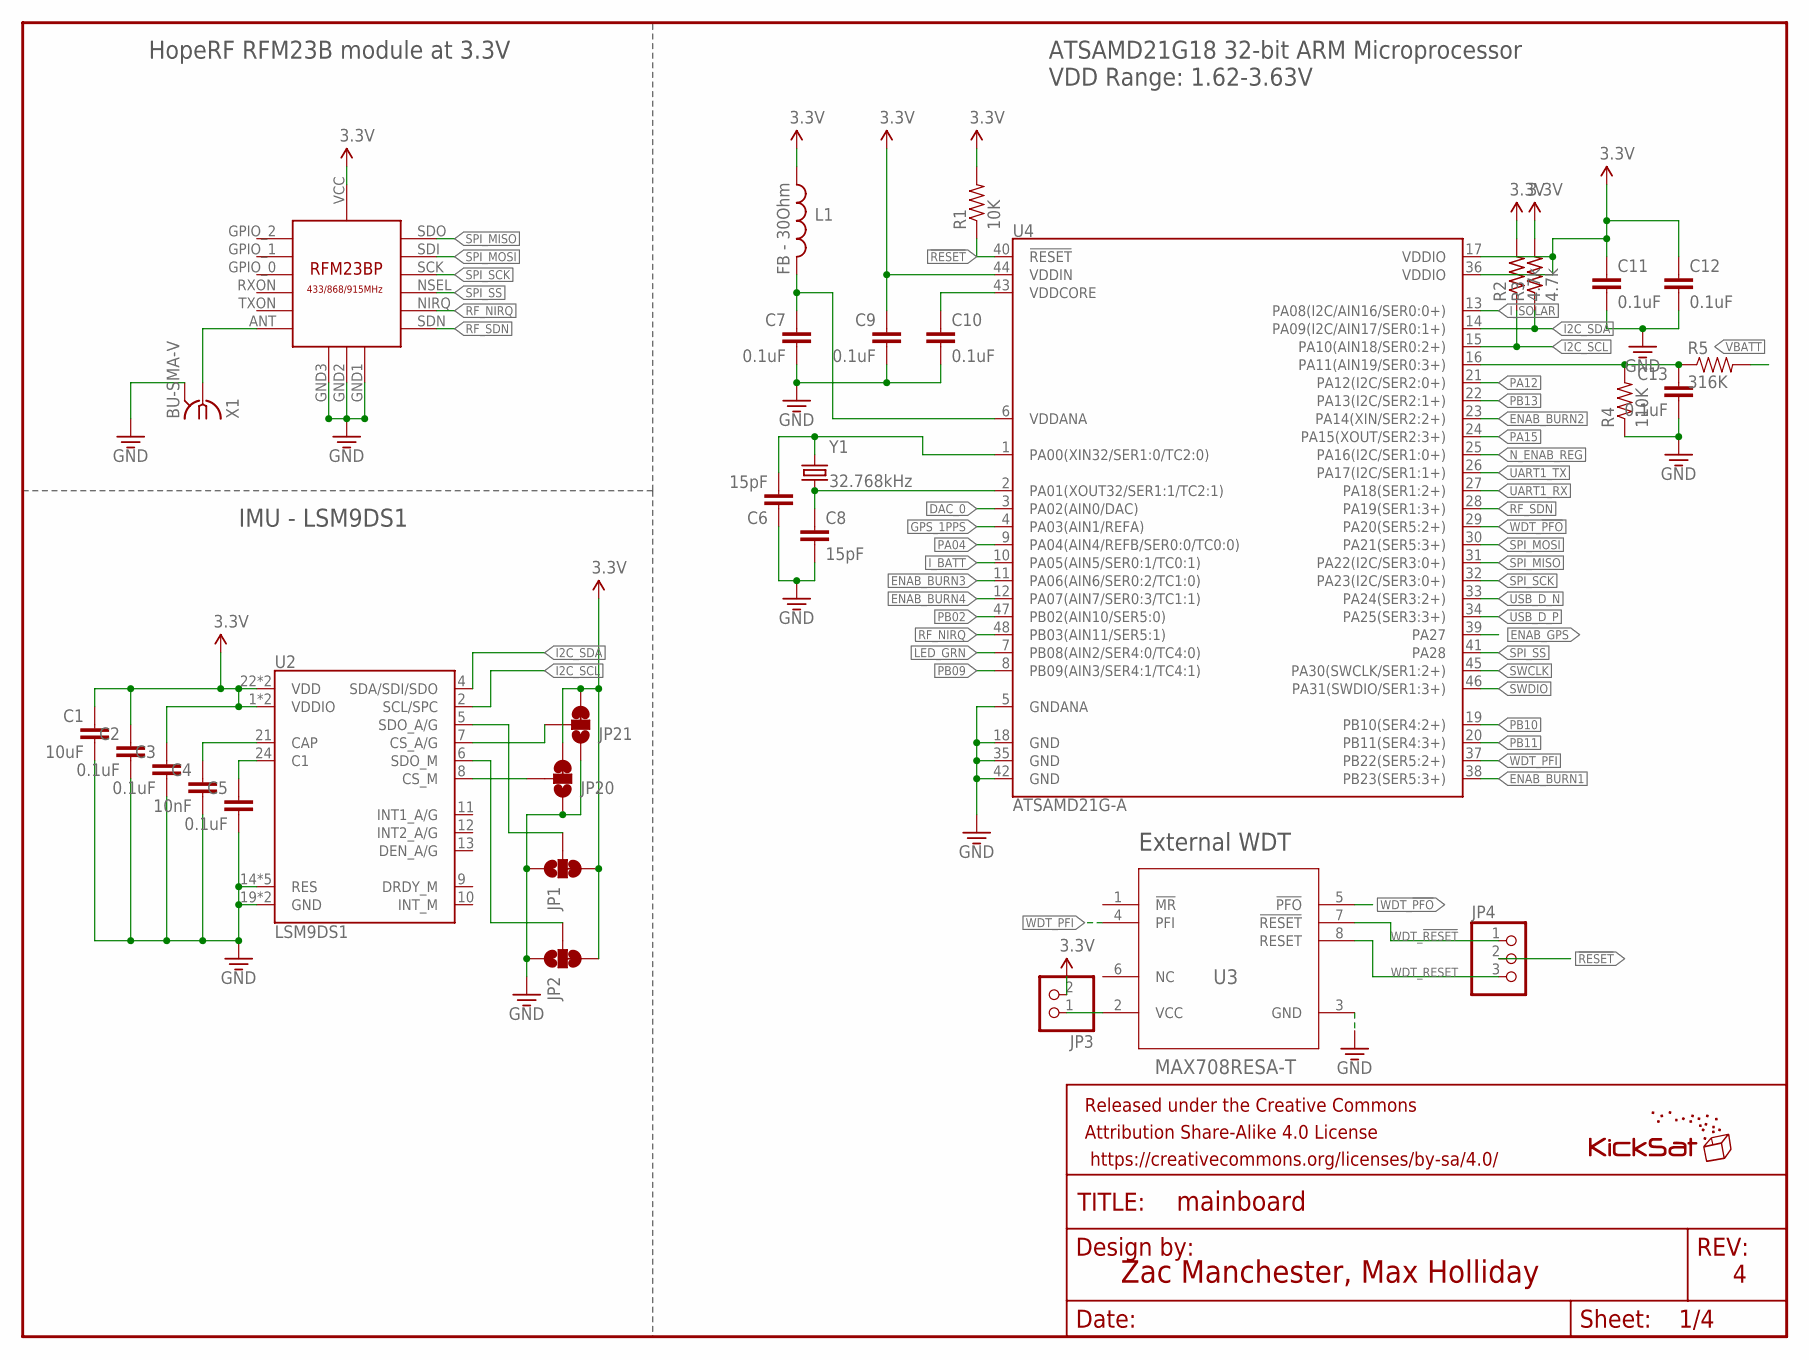
[picture p15: schematic Mainboard.sch, sheet 1, Avionics]

Parts:
C1: 10uF; 0603-CAP
C2, C3, C5, C7, C9, C10, C11, C12, C13: 0.1uF; 0603-CAP
C4: 10nF; 0603-CAP
C6, C8: 15pF; 0603-CAP@1
FRAME1: FRAME-LETTER; CREATIVE_COMMONS
JP1, JP2, JP20, JP21: JUMPER-PAD-3-2OF3_NC_BY_TRACE_SMALL; PAD-JUMPER-3-2OF3_NC_BY_TRACE_YES_SILK_FULL_BOX
JP3: PINHD-1X2; 1X02
JP4: PINHD-1X3; 1X03
L1: FB - 30Ohm; 0603
L2: KICKSAT_LOGO
R1: 10K; 0603-RES
R2, R3: 4.7k; R0603
R4: 110K; 0603-RES
R5: 316K; 0603-RES
U1: RFM23BP
U2: LSM9DS1; LGA24-8X4
U3: MAX708RESA-T; SO8
U4: ATSAMD21G-A; TQFP-48
X1: BU-SMA-V
Y1: 32.768kHz; CRYSTAL-SMD-3.2X1.5MM

Connections:
3.3V: C1.1, C2.1, C3.1, C9.1, C11.1, C12.1, JP1.3, JP2.3, JP3.2, JP20.3, JP21.3, L1.1, R1.2, R2.2, R3.2, U1.VCC, U2.1 (VDDIO), U2.3 (VDDIO), U2.22 (VDD), U2.23 (VDD), U4.17 (VDDIO), U4.36 (VDDIO), U4.44 (VDDIN); also elsewhere on the board
!RESET: JP4.2, R1.1, U4.40 (!RESET!); also elsewhere on the board
DAC_0: U4.3 (PA02(AIN0/DAC)); also elsewhere on the board
ENAB_BURN1: U4.38 (PB23(SER5:3+)); also elsewhere on the board
ENAB_BURN2: U4.23 (PA14(XIN/SER2:2+)); also elsewhere on the board
ENAB_BURN3: U4.11 (PA06(AIN6/SER0:2/TC1:0)); also elsewhere on the board
ENAB_BURN4: U4.12 (PA07(AIN7/SER0:3/TC1:1)); also elsewhere on the board
ENAB_GPS: U4.39 (PA27); also elsewhere on the board
GND: C1.2, C2.2, C3.2, C4.2, C5.2, C6.1, C7.2, C8.2, C9.2, C10.2, C11.2, C12.2, C13.2, JP1.1, JP2.1, JP20.1, JP21.1, R4.1, U1.GND1, U1.GND2, U1.GND3, U2.14 (RES), U2.15 (RES), U2.16 (RES), U2.17 (RES), U2.18 (RES), U2.19 (GND), U2.20 (GND), U3.3 (GND), U4.5 (GNDANA), U4.18 (GND), U4.35 (GND), U4.42 (GND), X1.2, X1.3 (2), X1.4 (2), X1.5 (2); also elsewhere on the board
GPS_1PPS: U4.4 (PA03(AIN1/REFA)); also elsewhere on the board
I2C_SCL: R2.1, U2.2 (SCL/SPC), U4.15 (PA10(AIN18/SER0:2+)); also elsewhere on the board
I2C_SDA: R3.1, U2.4 (SDA/SDI/SDO), U4.14 (PA09(I2C/AIN17/SER0:1+)); also elsewhere on the board
I2C_SDOA/G: JP1.2, U2.5 (SDO_A/G)
I_BATT: U4.10 (PA05(AIN5/SER0:1/TC0:1)); also elsewhere on the board
I_SOLAR: U4.13 (PA08(I2C/AIN16/SER0:0+)); also elsewhere on the board
LED_GRN: U4.7 (PB08(AIN2/SER4:0/TC4:0)); also elsewhere on the board
unnamed: C4.1, U2.21 (CAP)
unnamed: C5.1, U2.24 (C1)
unnamed: JP3.1, U3.2 (VCC)
unnamed: C7.1, L1.2, U4.6 (VDDANA)
unnamed: U1.ANT, X1.1
unnamed: JP2.2, U2.6 (SDO_M)
unnamed: JP20.2, U2.8 (CS_M)
unnamed: JP21.2, U2.7 (CS_A/G)
unnamed: C6.2, U4.1 (PA00(XIN32/SER1:0/TC2:0)), Y1.P$2 (2)
unnamed: C8.1, U4.2 (PA01(XOUT32/SER1:1/TC2:1)), Y1.P$1 (1)
unnamed: C13.1, R4.2, R5.1, U4.16 (PA11(AIN19/SER0:3+))
N_ENAB_REG: U4.25 (PA16(I2C/SER1:0+)); also elsewhere on the board
PA04: U4.9 (PA04(AIN4/REFB/SER0:0/TC0:0))
PA12: U4.21 (PA12(I2C/SER2:0+)); also elsewhere on the board
PA15: U4.24 (PA15(XOUT/SER2:3+))
PB02: U4.47 (PB02(AIN10/SER5:0)); also elsewhere on the board
PB09: U4.8 (PB09(AIN3/SER4:1/TC4:1)); also elsewhere on the board
PB10: U4.19 (PB10(SER4:2+)); also elsewhere on the board
PB11: U4.20 (PB11(SER4:3+)); also elsewhere on the board
PB13: U4.22 (PA13(I2C/SER2:1+))
RF_NIRQ: U1.NIRQ, U4.48 (PB03(AIN11/SER5:1))
RF_SDN: U1.SDN, U4.28 (PA19(SER1:3+))
SPI_MISO: U1.SDO, U4.31 (PA22(I2C/SER3:0+)); also elsewhere on the board
SPI_MOSI: U1.SDI, U4.30 (PA21(SER5:3+))
SPI_SCK: U1.SCK, U4.32 (PA23(I2C/SER3:0+)); also elsewhere on the board
SPI_SS: U1.NSEL, U4.41 (PA28)
SWCLK: U4.45 (PA30(SWCLK/SER1:2+)); also elsewhere on the board
SWDIO: U4.46 (PA31(SWDIO/SER1:3+)); also elsewhere on the board
UART1_RX: U4.27 (PA18(SER1:2+)); also elsewhere on the board
UART1_TX: U4.26 (PA17(I2C/SER1:1+)); also elsewhere on the board
USB_D_N: U4.33 (PA24(SER3:2+)); also elsewhere on the board
USB_D_P: U4.34 (PA25(SER3:3+)); also elsewhere on the board
VBATT: R5.2; also elsewhere on the board
VDDCORE3: C10.1, U4.43 (VDDCORE)
WDT_!PFO: U3.5 (!PFO), U4.29 (PA20(SER5:2+))
WDT_!RESET: JP4.1, U3.7 (!RESET)
WDT_PFI: U3.4 (PFI), U4.37 (PB22(SER5:2+))
WDT_RESET: JP4.3, U3.8 (RESET)

Notes on the sheet:
Zac Manchester, Max Holliday
ATSAMD21G18 32-bit ARM Microprocessor VDD Range: 1.62-3.63V
HopeRF RFM23B module at 3.3V
IMU - LSM9DS1
External WDT

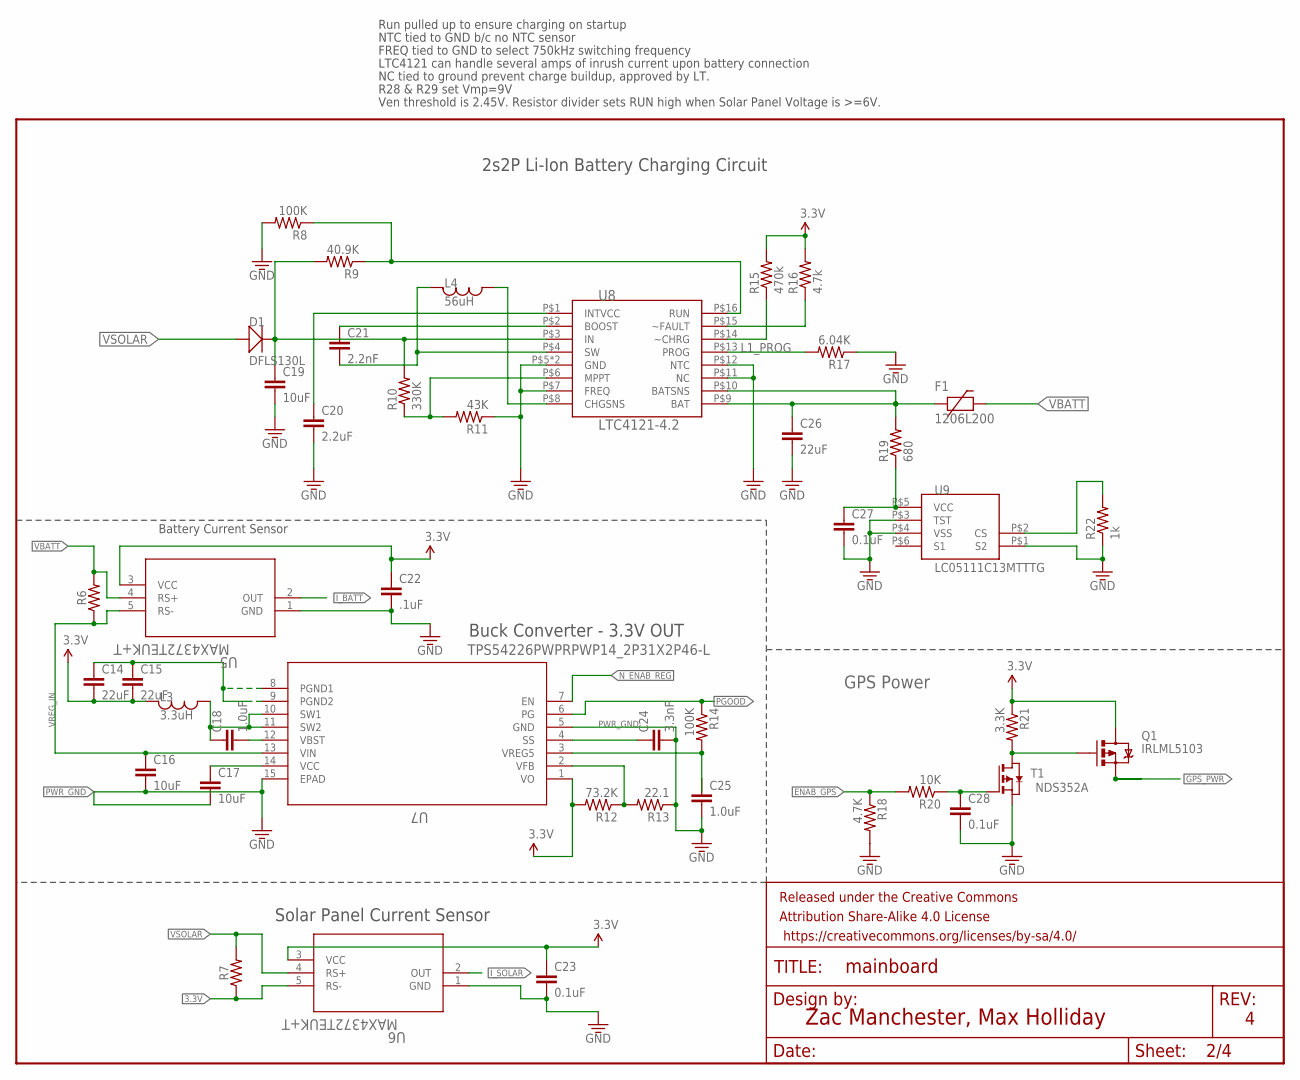
[picture p16: schematic Mainboard.sch, sheet 2, Power]

Parts:
C14, C15: 22uF; 0805
C16, C17, C19: 10uF; 0603
C18, C25: 1.0uF; 0603
C20: 2.2uF; 0603
C21: 2.2nF; 0603
C22: .1uF; 0603-CAP@1
C23, C27, C28: 0.1uF; 0603
C24: 3.3nF; 0603
C26: 22uF; 0603
D1: DFLS130L; PWRDI-123
F1: 1206L200; 1206
FRAME2: FRAME-LETTER; CREATIVE_COMMONS
L3: 3.3uH; 1812
L4: 56uH; 1812
Q1: IRLML5103; SOT23-3
R6, R7: 0603
R8, R14: 100K; R0603
R9: 40.9K; R0603
R10: 330K; R0603
R11: 43K; R0603
R12: 73.2K; R0603
R13: 22.1; R0603
R15: 470k; R0603
R16: 4.7k; R0603
R17: 6.04K; R0603
R18: 4.7K; R0603
R19: 680; R0603
R20: 10K; R0603
R21: 3.3K; R0603
R22: 1k; R0603
T1: NDS352A; SOT-23
U5, U6: MAX4372TEUK+T; 21-0057F
U7: TPS54226PWPRPWP14_2P31X2P46-L; PWP14_2P31X2P46-L
U8: LTC4121-4.2; QFN-16-PAD
U9: LC05111C13MTTTG; WDFN6

Connections:
3.3V: C14.2, C15.2, C22.1, C23.1, L3.P$1, Q1.3 (D), R7.1, R12.2, R15.2, R16.2, R21.1, U5.3 (VCC), U6.3 (VCC), U6.5 (RS-), U7.1 (VO); also elsewhere on the board
ENAB_GPS: R18.1, R20.2; also elsewhere on the board
GND: C19.2, C20.2, C22.2, C23.2, C26.2, C27.2, C28.2, R8.2, R11.1, R17.1, R18.2, R22.1, T1.2 (S), U5.1 (GND), U6.1 (GND), U8.P$5 (GND), U8.P$7 (FREQ), U8.P$11 (NC), U8.P$12 (NTC), U8.P$17 (GND), U9.P$1 (S2), U9.P$3 (TST), U9.P$4 (VSS); also elsewhere on the board
GPS_PWR: Q1.2 (S); also elsewhere on the board
I_BATT: U5.2 (OUT); also elsewhere on the board
I_SOLAR: U6.2 (OUT); also elsewhere on the board
L1_CHG: R8.1, R9.1, U8.P$16 (RUN)
L1_FAULTN: R16.1, U8.P$15 (~FAULT)
L1_PROG: R17.2, U8.P$13 (PROG)
LION1: C26.1, F1.1, R19.2, U8.P$9 (BAT), U8.P$10 (BATSNS)
unnamed: C18.1, L3.P$2, U7.10 (SW1), U7.11 (SW2)
unnamed: C28.1, R20.1, T1.3 (G)
unnamed: Q1.1 (G), R21.2, T1.1 (D)
unnamed: C18.2, U7.12 (VBST)
unnamed: C21.2, L4.P$1, U8.P$4 (SW)
unnamed: C21.1, U8.P$2 (BOOST)
unnamed: C20.1, U8.P$1 (INTVCC)
unnamed: R10.1, R11.2, U8.P$6 (MPPT)
unnamed: L4.P$2, U8.P$8 (CHGSNS)
unnamed: R15.1, U8.P$14 (~CHRG)
unnamed: C27.1, R19.1, U9.P$5 (VCC)
unnamed: C17.1, U7.14 (VCC)
unnamed: R22.2, U9.P$2 (CS)
unnamed: C25.1, R14.2, U7.3 (VREG5)
unnamed: C24.1, U7.4 (SS)
unnamed: R12.1, R13.2, U7.2 (VFB)
N_ENAB_REG: U7.7 (EN); also elsewhere on the board
PGOOD: R14.1, U7.6 (PG)
PWR_GND: C14.1, C15.1, C16.2, C17.2, C24.2, C25.2, R13.1, U7.5 (GND), U7.8 (PGND1), U7.9 (PGND2), U7.15 (EPAD)
VBATT: F1.2, R6.2, U5.4 (RS+); also elsewhere on the board
VREG_IN: C16.1, R6.1, U5.5 (RS-), U7.13 (VIN)
VSOLAR: D1.A, R7.2, U6.4 (RS+); also elsewhere on the board
VSOLAR_IN: C19.1, D1.C, R9.2, R10.2, U8.P$3 (IN)

Notes on the sheet:
Solar Panel Current Sensor
Battery Current Sensor
Zac Manchester, Max Holliday
GPS Power
FREQ tied to GND to select 750kHz switching frequency
R28 & R29 set Vmp=9V
2s2P Li-Ion Battery Charging Circuit
Run pulled up to ensure charging on startup
NTC tied to GND b/c no NTC sensor
LTC4121 can handle several amps of inrush current upon battery connection
NC tied to ground prevent charge buildup, approved by LT.
Ven threshold is 2.45V. Resistor divider sets RUN high when Solar Panel Voltage is >=6V.
Buck Converter - 3.3V OUT

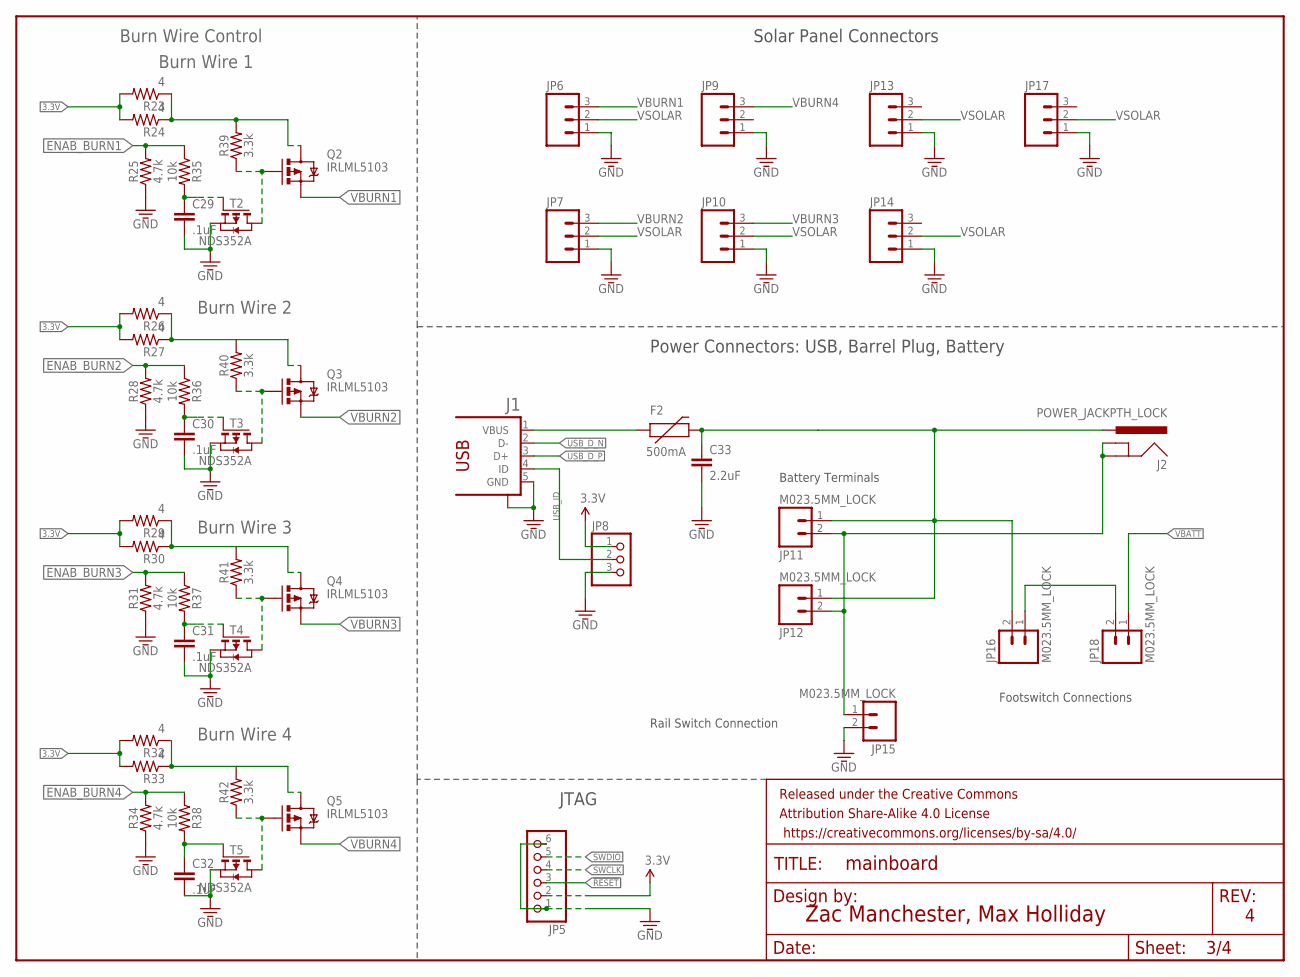
[picture p17: schematic Mainboard.sch, sheet 3, Connectors]

Parts:
C29, C30, C31, C32: .1uF; 0603-CAP@1
C33: 2.2uF; 0603
F2: 500mA; PTC-1206
FRAME3: FRAME-LETTER; CREATIVE_COMMONS
J1: 1981584-1
J2: POWER_JACKPTH_LOCK; POWER_JACK_PTH_LOCK
JP5: PINHD-1X6; 1X06
JP6, JP7, JP9, JP10, JP13, JP14, JP17: M03POLAR_LOCK; MOLEX-1X3_LOCK
JP8: PINHD-1X3; 1X03
JP11, JP12, JP15, JP16, JP18: M023.5MM_LOCK; SCREWTERMINAL-3.5MM-2_LOCK
Q2, Q3, Q4, Q5: IRLML5103; SOT23-3
R23, R24, R26, R27, R29, R30, R32, R33: 4; R0603
R25, R28, R31, R34: 4.7k; 0603
R35, R36, R37, R38: 10k; 0603
R39, R40, R41, R42: 3.3k; 0603
T2, T3, T4, T5: NDS352A; SOT-23

Connections:
3.3V: JP5.2, JP8.1, R23.2, R24.2, R26.2, R27.2, R29.2, R30.2, R32.2, R33.2; also elsewhere on the board
!RESET: JP5.3; also elsewhere on the board
ENAB_BURN1: R25.2, R35.1; also elsewhere on the board
ENAB_BURN2: R28.2, R36.1; also elsewhere on the board
ENAB_BURN3: R31.2, R37.1; also elsewhere on the board
ENAB_BURN4: R34.2, R38.1; also elsewhere on the board
GND: C29.2, C30.2, C31.2, C32.2, C33.2, J1.5 (GND), J1.S1, JP5.1, JP5.6, JP6.1, JP7.1, JP8.3, JP9.1, JP10.1, JP13.1, JP14.1, JP15.2, JP17.1, R25.1, R28.1, R31.1, R34.1, T2.2 (S), T3.2 (S), T4.2 (S), T5.2 (S); also elsewhere on the board
unnamed: JP16.1, JP18.2
unnamed: C30.1, R36.2, T3.3 (G)
unnamed: Q2.1 (G), R39.1, T2.1 (D)
unnamed: C31.1, R37.2, T4.3 (G)
unnamed: F2.1, J1.1 (VBUS)
unnamed: Q3.1 (G), R40.1, T3.1 (D)
unnamed: J2.GND, J2.GNDBREAK, JP11.2, JP12.2, JP15.1
unnamed: C29.1, R35.2, T2.3 (G)
unnamed: C32.1, R38.2, T5.3 (G)
unnamed: Q4.1 (G), R41.1, T4.1 (D)
unnamed: Q5.1 (G), R42.1, T5.1 (D)
SWCLK: JP5.4; also elsewhere on the board
SWDIO: JP5.5; also elsewhere on the board
USB_D_N: J1.2 (D-); also elsewhere on the board
USB_D_P: J1.3 (D+); also elsewhere on the board
USB_ID: J1.4 (ID), JP8.2
VBATT: C33.1, F2.2, J2.PWR, JP11.1, JP12.1, JP16.2, JP18.1; also elsewhere on the board
VBURN1: JP6.3, Q2.2 (S)
VBURN2: JP7.3, Q3.2 (S)
VBURN3: JP10.3, Q4.2 (S)
VBURN4: JP9.3, Q5.2 (S)
VBURN_IN: Q2.3 (D), Q3.3 (D), Q4.3 (D), Q5.3 (D), R23.1, R24.1, R26.1, R27.1, R29.1, R30.1, R32.1, R33.1, R39.2, R40.2, R41.2, R42.2
VSOLAR: JP6.2, JP7.2, JP10.2, JP13.2, JP14.2, JP17.2; also elsewhere on the board

Notes on the sheet:
Footswitch Connections
Solar Panel Connectors
Battery Terminals
Rail Switch Connection
Zac Manchester, Max Holliday
JTAG
Power Connectors: USB, Barrel Plug, Battery
Burn Wire 1
Burn Wire Control
Burn Wire 2
Burn Wire 3
Burn Wire 4

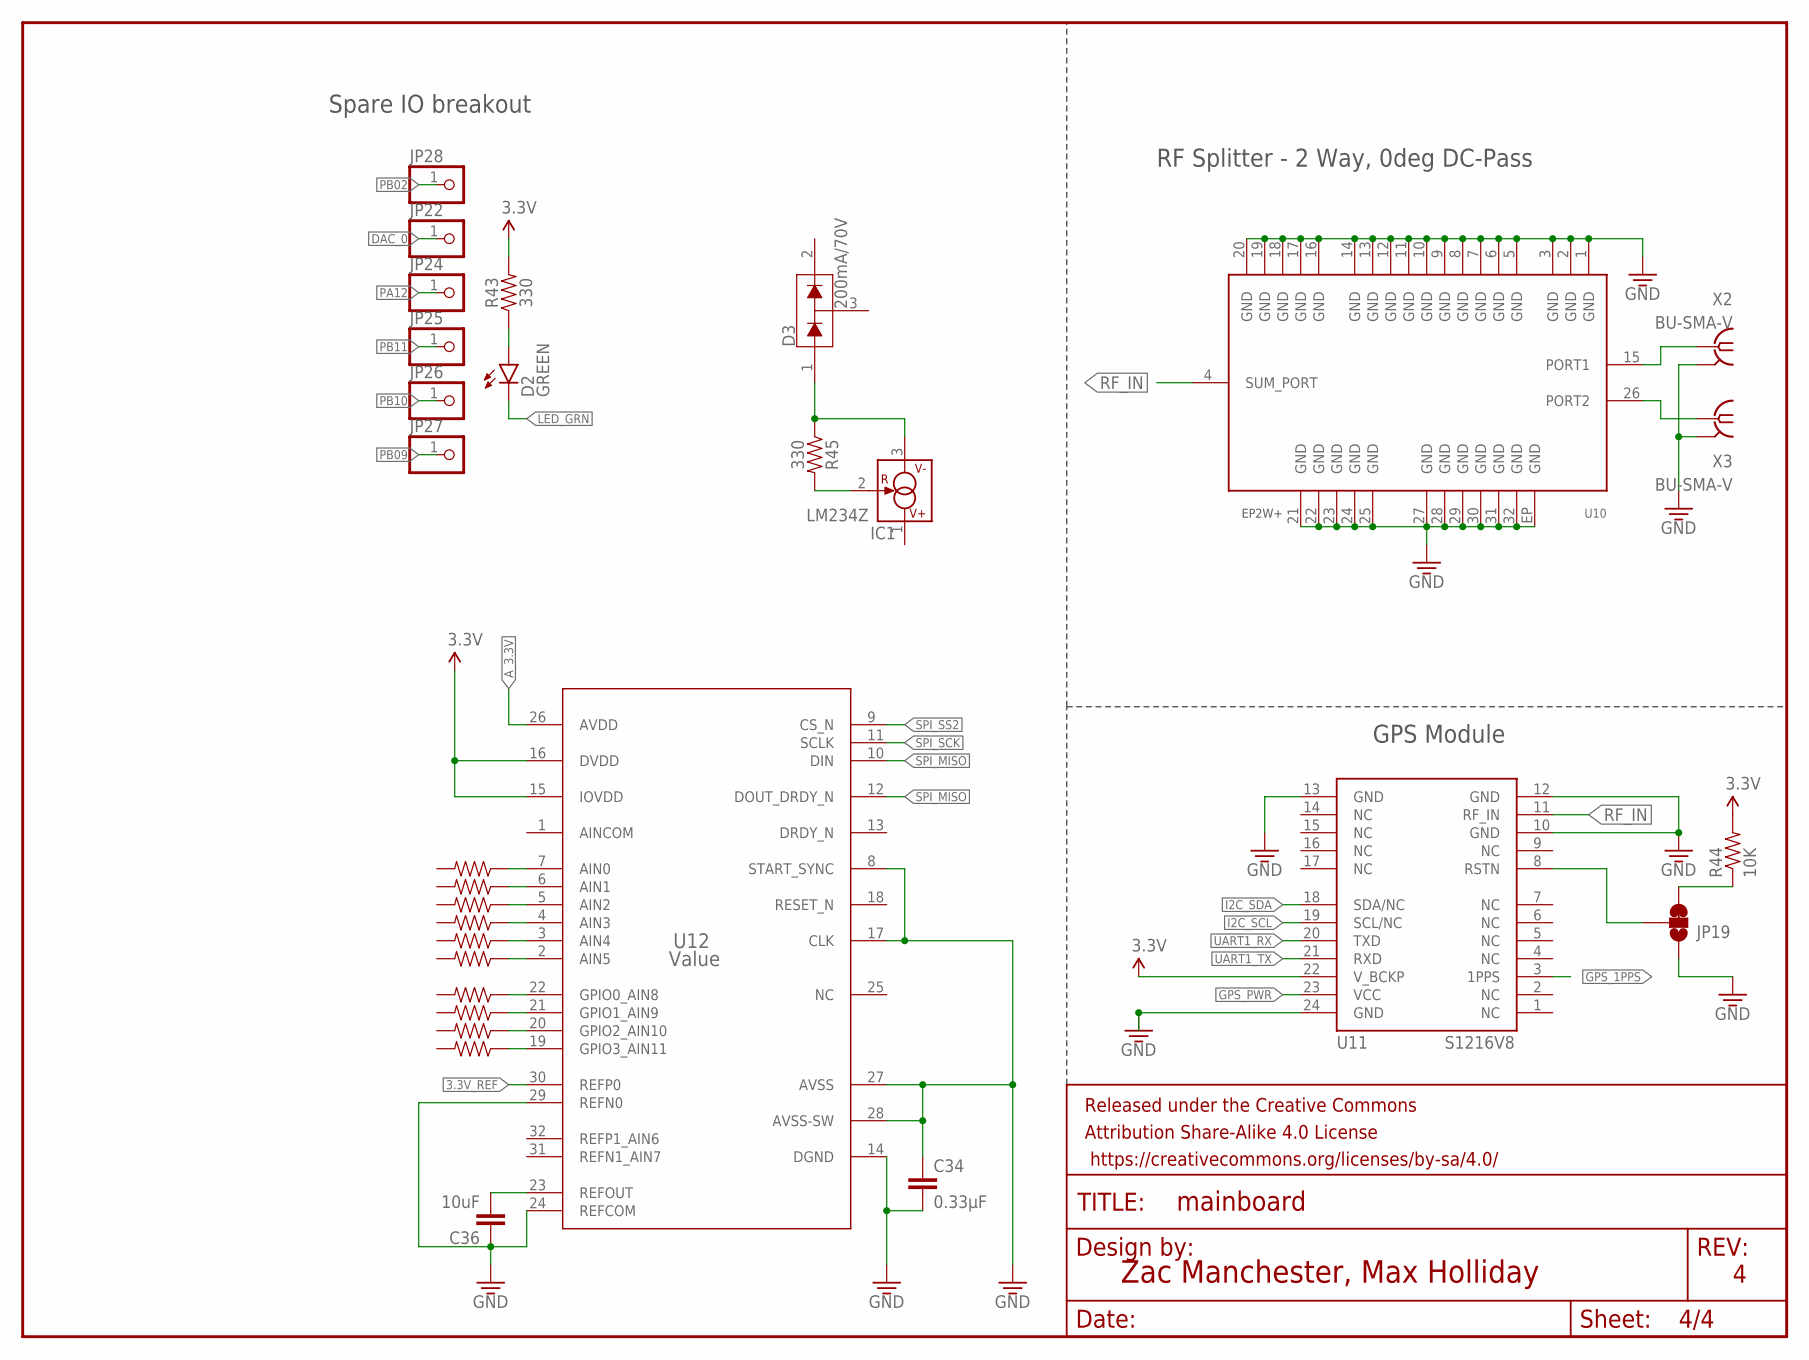
[picture p18: schematic Mainboard.sch, sheet 4, RF and GPS]

Parts:
C34: 0.33µF; 0805
C36: 10uF; 0603
D2: GREEN; LED-0603
D3: 200mA/70V; SOT23-3
FRAME4: FRAME-LETTER; CREATIVE_COMMONS
IC1: LM234Z; TO92
JP19: JUMPER-PAD-3-2OF3_NC_BY_TRACE_SMALL; PAD-JUMPER-3-2OF3_NC_BY_TRACE_YES_SILK_FULL_BOX
JP22, JP24, JP25, JP26, JP27, JP28: PINHD-1X1; 1X01
R43, R45: 330; 0603-RES
R44, R46, R47, R48, R49, R50, R51, R52, R53, R54, R55: 10K; 0603-RES
U10: EP2W+; QFN32-5X5MM
U11: S1216V8; S1216_24PIN_PACKAGE
U12: Value; PBS0032A_N
X2, X3: BU-SMA-V

Connections:
3.3V: R43.2, R44.2, U11.22 (V_BCKP), U12.15 (IOVDD), U12.16 (DVDD); also elsewhere on the board
3.3V_REF: U12.30 (REFP0)
A_3.3V: U12.26 (AVDD)
DAC_0: JP22.1; also elsewhere on the board
GND: C34.1, C34.2, C36.1, JP19.1, U10.1 (GND), U10.2 (GND), U10.3 (GND), U10.5 (GND), U10.6 (GND), U10.7 (GND), U10.8 (GND), U10.9 (GND), U10.10 (GND), U10.11 (GND), U10.12 (GND), U10.13 (GND), U10.14 (GND), U10.16 (GND), U10.17 (GND), U10.18 (GND), U10.19 (GND), U10.20 (GND), U10.21 (GND), U10.22 (GND), U10.23 (GND), U10.24 (GND), U10.25 (GND), U10.27 (GND), U10.28 (GND), U10.29 (GND), U10.30 (GND), U10.31 (GND), U10.32 (GND), U10.EP (GND), U11.10 (GND), U11.12 (GND), U11.13 (GND), U11.24 (GND), U12.8 (START_SYNC), U12.14 (DGND), U12.17 (CLK), U12.24 (REFCOM), U12.27 (AVSS), U12.28 (AVSS-SW), U12.29 (REFN0), X2.2, X2.3 (2), X2.4 (2), X2.5 (2), X3.2, X3.3 (2), X3.4 (2), X3.5 (2); also elsewhere on the board
GPS_1PPS: U11.3 (1PPS); also elsewhere on the board
GPS_PWR: U11.23 (VCC); also elsewhere on the board
I2C_SCL: U11.19 (SCL/NC); also elsewhere on the board
I2C_SDA: U11.18 (SDA/NC); also elsewhere on the board
LED_GRN: D2.C; also elsewhere on the board
unnamed: D2.A, R43.1
unnamed: JP19.2, U11.8 (RSTN)
unnamed: U10.15 (PORT1), X2.1
unnamed: U10.26 (PORT2), X3.1
unnamed: R47.1, U12.7 (AIN0)
unnamed: JP19.3, R44.1
unnamed: R48.1, U12.6 (AIN1)
unnamed: R49.1, U12.5 (AIN2)
unnamed: IC1.2 (R), R45.2
unnamed: D3.1 (A1), IC1.3 (V-), R45.1
unnamed: R50.1, U12.4 (AIN3)
unnamed: R51.1, U12.3 (AIN4)
unnamed: R52.1, U12.2 (AIN5)
unnamed: R46.1, U12.22 (GPIO0_AIN8)
unnamed: R53.1, U12.21 (GPIO1_AIN9)
unnamed: C36.2, U12.23 (REFOUT)
unnamed: R54.1, U12.20 (GPIO2_AIN10)
unnamed: R55.1, U12.19 (GPIO3_AIN11)
PA12: JP24.1; also elsewhere on the board
PB02: JP28.1; also elsewhere on the board
PB09: JP27.1; also elsewhere on the board
PB10: JP26.1; also elsewhere on the board
PB11: JP25.1; also elsewhere on the board
RF_IN: U10.4 (SUM_PORT), U11.11 (RF_IN)
SPI_MISO: U12.10 (DIN), U12.12 (DOUT_DRDY_N); also elsewhere on the board
SPI_SCK: U12.11 (SCLK); also elsewhere on the board
SPI_SS2: U12.9 (CS_N)
UART1_RX: U11.20 (TXD); also elsewhere on the board
UART1_TX: U11.21 (RXD); also elsewhere on the board

Notes on the sheet:
GPS Module
RF Splitter - 2 Way, 0deg DC-Pass
Zac Manchester, Max Holliday
Spare IO breakout

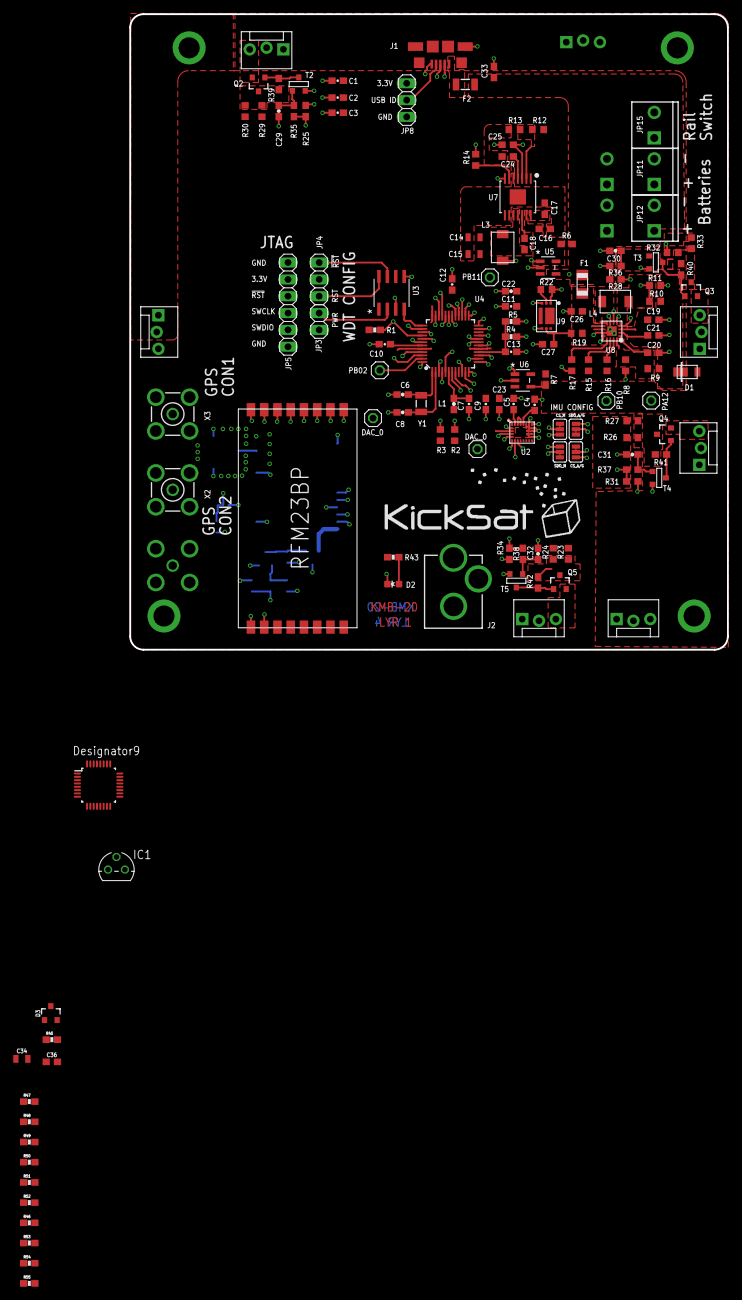
[picture p19: board Mainbaord.brd from above]

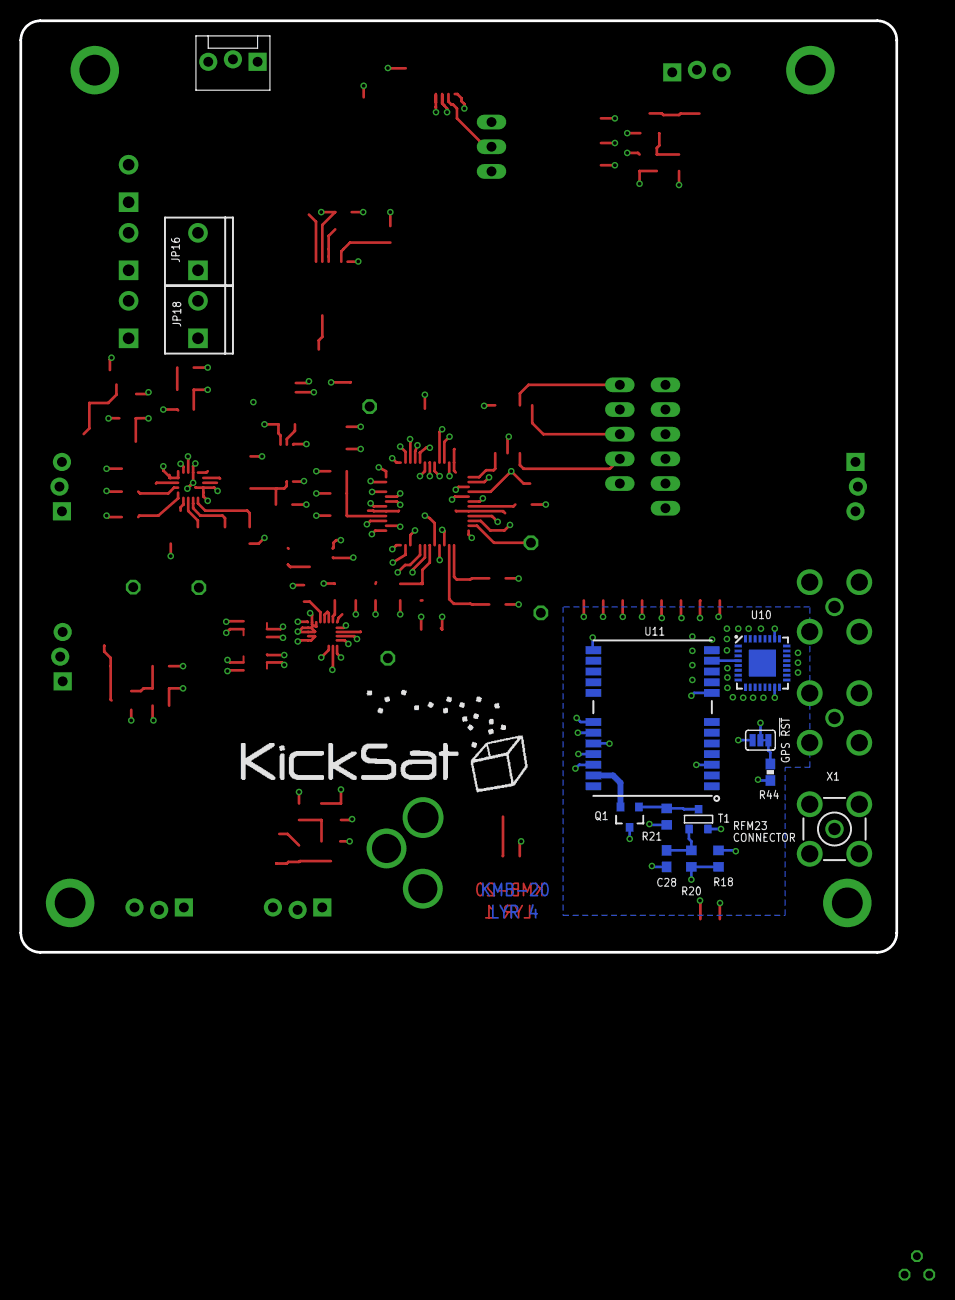
[picture p20: board Mainbaord.brd from below]

Board: 4 copper layers, 90.2 x 95.9 mm, 160 parts (15 on the bottom side), 113 nets.

Other parts of the board:
L5: KICKSAT_LOGO
