kicksat/avionics/flight_computer.brd

## EAGLE design flight_computer.brd (2014-06-02)

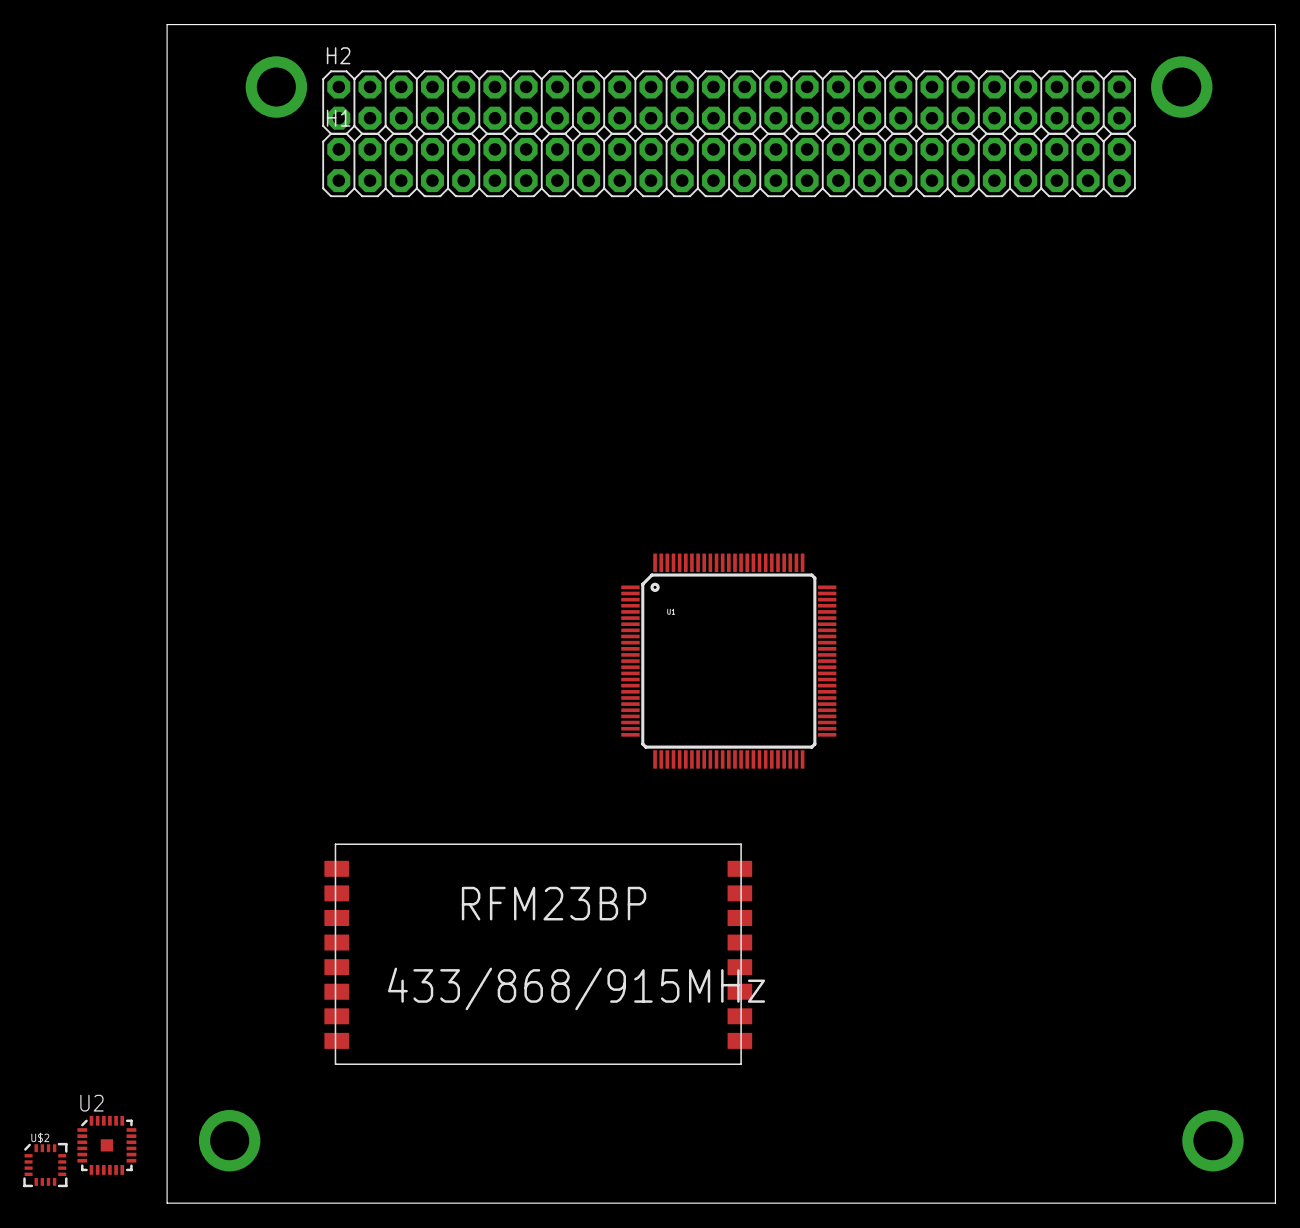
[picture p21: board flight_computer.brd from above]

Board: 2 copper layers, 90.2 x 95.9 mm, 6 parts (0 on the bottom side), 4 nets, no tracks yet.

Parts:
H1, H2: PINHD-2X26; 2X26
U1: ATMEGA2560AU; TQFP100
U2: ITG-3200; QFN-24
U$1: RFM23BP
U$2: HMC5883LSMD; 16LPCC

Connections:
GND1: U1.32, U$1.GND1
GND2: U1.62, U$1.GND2
GND3: U1.81, U$1.GND3
VCC: U1.10, U$1.VCC
