kicksat/avionics/(commit log)

2014-06-02 Initial move
    [flight_computer.brd, flight_computer.sch]
2014-06-02 rename main board
    [mainboard.brd, mainboard.sch]
2014-06-05 Added documentation
    [mainboard.brd, mainboard.sch]
2014-06-19 Added libraries for balun and tape measure antenna
    [antenna.brd, antenna.sch]
2014-06-20 Antenna layout
    [antenna.brd]
2014-06-23 changed antenna ground plane
    [antenna.brd]
2014-06-24 Positioned mounting holes on antenna board
    [antenna.brd]
2014-06-24 Antenna board silkscreen and gerbers
    [antenna.brd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]
2014-06-25 Changed antenna board to 2 cutouts
    [antenna.brd]
2014-06-25 Mitered corners of mainboard
    [antenna.brd, mainboard.brd]
2014-06-25 Deleted old berbers
    [antenna.GBL, antenna.GBO, antenna.GBS, antenna.GTL, antenna.GTO, antenna.GTS]
2014-06-25 Added level shifter
    [mainboard.brd, mainboard.sch]
2014-07-01 Fixed silkscreen on antenna board
    [antenna.brd]
2014-07-01 Tweaks to antenna board
    [antenna.brd]
2014-07-02 Initial commit of power board
    [mainboard.brd, mainboard.sch, power.brd, power.sch]
2014-07-08 Added RTC
    [mainboard.brd, mainboard.sch]
2014-07-08 Added Micrel voltage supervisors
    [mainboard.brd, mainboard.sch]
2014-07-09 Added new side solar panel
    [mainboard.brd, mainboard.sch, side_panel.brd, side_panel.sch]
2014-07-11 Fixed manufacturing issue on TASC cell footprint
    [side_panel.brd, side_panel.sch]
2014-07-21 Added latch-up protection circuits to main board
    [mainboard.brd, mainboard.sch]
2014-07-22 Fixed solar panel issue
    [side_panel.brd, side_panel.sch]
2014-07-22 Added solar panel libraries
    [power.brd, power.sch]
2014-07-22 Added RTC backup batteries
    [power.brd, power.sch]
2014-07-22 Power board work
    [power.brd, power.sch]
2014-07-29 Added LT3688 dual regulator
    [power.brd, power.sch]
2014-07-29 More switching regulator work
    [power.brd, power.sch]
2014-07-29 Finished regulator circuit design
    [power.brd, power.sch]
2014-07-30 Added foot switch terminals to power board
    [power.brd, power.sch]
2014-07-30 Added current sensors to power board
    [power.brd, power.sch]
2014-07-30 Changed to all sparkfun library parts
    [power.brd, power.sch]
2014-08-01 Board layout for switching regulator
    [power.brd]
2014-08-01 More power board layout work
    [power.brd]
2014-08-11 Added breakout for USB and charging
    [mainboard.brd, mainboard.sch, ports.brd, ports.sch, power.brd, power.sch]
2014-08-11 Removed silkscreen from gecko connector footprint
    [power.brd, power.sch]
2014-08-11 Updated ports board
    [ports.brd, ports.sch]
2014-08-11 Updated Gecko Connector
    [power.brd, power.sch, side_panel.brd, side_panel.sch]
2014-08-11 Switching to teensy for flight computer
    [antenna.brd, mainboard.brd, mainboard.sch, power.brd, power.sch]
2014-08-12 Merged power and main board
    [mainboard.brd, mainboard.sch, power.brd, power.sch]
2014-08-12 Mainboard layout work
    [mainboard.brd, mainboard.sch]
2014-08-12 More layout work on main board
    [mainboard.brd, mainboard.sch]
2014-08-12 Finished RTC schematic
    [mainboard.brd, mainboard.sch]
2014-08-13 Got rid of level shifter for RF23BP
    Looks like it’s not necessary after some experimentation
    [mainboard.brd, mainboard.sch]
2014-08-19 More layout work
    [mainboard.brd, mainboard.sch]
2014-08-19 More layout work
    Changed radio + ska position to accomodate USB for teensy
    [mainboard.brd]
2014-08-19 More main board layout
    [mainboard.brd, mainboard.sch]
2014-08-19 Added OSHPark design rules
    [mainboard.brd, ports.brd]
2014-08-20 main board layout work
    [mainboard.brd, mainboard.sch]
2014-08-20 Finished main board layout
    [mainboard.brd, mainboard.sch, side_panel.brd, side_panel.sch]
2014-08-20 Increased size of tape antenna solder pads
    [antenna.brd, antenna.sch]
2014-08-21 Silkscreen Cleanup
    [mainboard.brd, mainboard.sch]
2014-08-21 Added OSHPark Cam jobs + gerbers for main board
    [mainboard.brd]
2014-08-21 Switched some components from 0603 to 0805
    [Mainbord BOM.xlsx, mainboard.brd, mainboard.sch]
2014-08-21 Changed to 6mil tolerances
    [Mainbord BOM.xlsx, mainboard.brd]
2014-08-21 Updated BOM with Digikey part numbers
    [Mainbord BOM.xlsx]
2014-08-21 BOM Updates
    [Mainbord BOM.xlsx]
2014-08-29 Widened copper around Gecko connector holes
    [mainboard.brd, mainboard.sch, ports.brd, ports.sch, side_panel.brd, side_panel.sch]
2014-08-29 Move Gecko connector on ports board in from edge
    [ports.brd]
2014-08-29 Fixed small silkscreen error
    [mainboard.brd]
2014-09-09 Fixed burn wire
    [side_panel.brd]
2014-09-09 Fixed solar panel silkscreen
    [side_panel.brd]
2014-10-22 Beginning of new solar panel layout
    Changing to pairs of TASC cells to accommodate irregularities in
    dimensions
    [Mainbord BOM.xlsx, side_panel.brd, side_panel.sch]
2014-10-23 New rev - cells in parallel
    [side_panel.brd]
2014-10-23 Revert "New rev - cells in parallel"
    This reverts commit faff168c3f4bc65dfe0481fd6277a3f779fa2b6e.
    [side_panel.brd]
2014-10-25 New side panel layout
    [side_panel.brd]
2014-10-27 Revert 959c034..d13c0e4
    This rolls back to commit 959c03423f2cbd105642679eef46985d8f87b8b7.
    [side_panel.brd]
2014-10-27 Fixed some schematic + layout issues on solar panel
    This reverts commit 959c03423f2cbd105642679eef46985d8f87b8b7.
    Conflicts:
    side_panel.brd
    [side_panel.brd, side_panel.sch]
2014-10-27 Finished solar panel layout
    [side_panel.brd, side_panel.sch]
2014-10-28 Changed silkscreen to bPlace layer on solar panel
    [side_panel.brd]
2014-11-20 Swapped out power regulator
    [mainboard.brd, mainboard.sch]
2014-12-05 Added solar cells to antenna board
    [antenna.brd, antenna.sch]
2014-12-05 Updated side panel connectors
    [side_panel.brd, side_panel.sch]
2015-01-14 Fixed silkscreen error
    [mainboard.brd]
2015-08-21 Antenna board tweaks
    Changed connectors, fixed solar panel mirroring issue
    [antenna.brd, antenna.sch]
2015-08-21 Antenna board connector fix
    [antenna.brd, antenna.sch]
2015-08-21 Removed beta batteries
    [mainboard.brd, mainboard.sch]
2015-08-24 New solar panel design
    [SideSolarPanel.brd, SideSolarPanel.sch, mainboard.brd, mainboard.sch, ports.brd, ports.sch]
2015-08-28 Added "CUT OUT" text to cut outs
    [antenna.brd]
2015-09-08 Updates to antenna board
    Fixed corner cutout dimensions. Added 3-pin Molex connector. Added
    “CUTOUT” text to dimension layer.
    [antenna.brd, antenna.sch]
2015-09-08 Different X and Y side panels
    [SideSolarPanel.brd, SideSolarPanel.sch, SideXSolarPanel.brd, SideXSolarPanel.sch, SideYSolarPanel.brd, SideYSolarPanel.sch]
2015-09-08 Change mounting hole diameter
    [SideXSolarPanel.brd, SideYSolarPanel.brd]
2015-09-09 Solar panel layout work
    [SideXSolarPanel.brd]
2015-09-09 Finished routing X solar panel
    [SideXSolarPanel.brd]
2015-09-09 Moved screw holes on solar panel
    [SideXSolarPanel.brd]
2015-09-09 Finished routing Y solar panel
    [SideXSolarPanel.brd, SideYSolarPanel.brd, SideYSolarPanel.sch]
2015-09-09 Increased cutout line width
    [SideXSolarPanel.brd, SideYSolarPanel.brd, antenna.brd]
2015-09-10 Added pull down resistors to burn wire circuits
    [mainboard.brd, mainboard.sch]
2015-09-10 Added stuff to mainboard for NanoRacks requirements
    [mainboard.brd, mainboard.sch]
2015-09-11 Adding Arduino Pro Mini to Mainboard
    [mainboard.brd, mainboard.sch, side_panel.brd, side_panel.sch]
2015-09-12 Added switches for programming mode
    [mainboard.brd, mainboard.sch]
2015-09-12 Moved power connector
    [mainboard.brd]
2015-09-14 Fixed charging jack on schematic
    [mainboard.brd, mainboard.sch]
2015-09-14 DPDT Switch for programming mode
    [mainboard.brd, mainboard.sch]
2015-09-14 Swapped X and Y solar panels per NanoRacks ICD
    [SideXSolarPanel.brd, SideXSolarPanel.sch, SideYSolarPanel.brd, SideYSolarPanel.sch]
2015-09-15 added piksi gps connector and enable circuitry. Added molex library
    [mainboard.brd, mainboard.sch]
2015-09-15 Schematic clean-up
    [mainboard.brd, mainboard.sch]
2015-09-15 Mainboard routing work
    [mainboard.brd, mainboard.sch]
2015-09-16 Some layout work
    [mainboard.brd, mainboard.sch]
2015-09-17 Finished routing mainboard
    [mainboard.brd, mainboard.sch]
2015-09-17 Added KickSat Logo
    [mainboard.brd]
2015-09-17 Silkscreen Fix
    [mainboard.brd]
2015-09-17 Updated BOM
    [Mainboard BOM.xlsx, Mainbord BOM.xlsx]
2015-09-22 Beginning of top solar panel
    [TopSolarPanel.brd, TopSolarPanel.sch]
2015-09-22 Fixed solar cell footprints
    [SideXSolarPanel.brd, SideXSolarPanel.sch, SideYSolarPanel.brd, SideYSolarPanel.sch, TopSolarPanel.brd, TopSolarPanel.sch, antenna.brd, antenna.sch]
2015-09-23 New top solar panel
    [TopSolarPanel.brd, TopSolarPanel.sch]
2015-09-23 Changed antenna board to accommodate pumpkin clips
    [antenna.brd]
2015-09-23 Changed top board dimensions
    [TopSolarPanel.brd]
2015-09-25 Adding pogo board
    [PogoBoard.brd, PogoBoard.sch]
2015-09-25 Changed pogo board screws to M3
    [PogoBoard.brd, PogoBoard.sch]
2015-11-01 Fixed bad trace on Y solar panel
    [SideYSolarPanel.brd]
2015-12-05 Changed R4 value on mainboard
    [Mainboard.brd, Mainboard.sch]
2015-12-13 Added cap to battery voltage divider ADC input
    [Mainboard.brd, Mainboard.sch]
2015-12-13 Changed voltage divider resistor values
    [Mainboard.brd, Mainboard.sch]
2016-02-21 Trimmed corners of top solar panel
    [TopSolarPanel.brd]
2017-02-05 Added battery voltage monitoring to arduino
    [Mainboard.brd, Mainboard.sch]
2018-04-04 Added kicksat2 mainboard
    Took a snapshot of kicksat1 files, then added new mainboard schematic/layout/libraries
    [Antenna.brd, Antenna.sch, Mainbaord.brd, Mainboard BOM.xlsx, Mainboard.brd, Mainboard.sch, PogoBoard.brd, PogoBoard.sch]
